AlbertGBarber/Pixel-Mask/PCB Ver Stuff and Code (not for Instructable)/PCB Files/IMG_20201108_145438.jpg

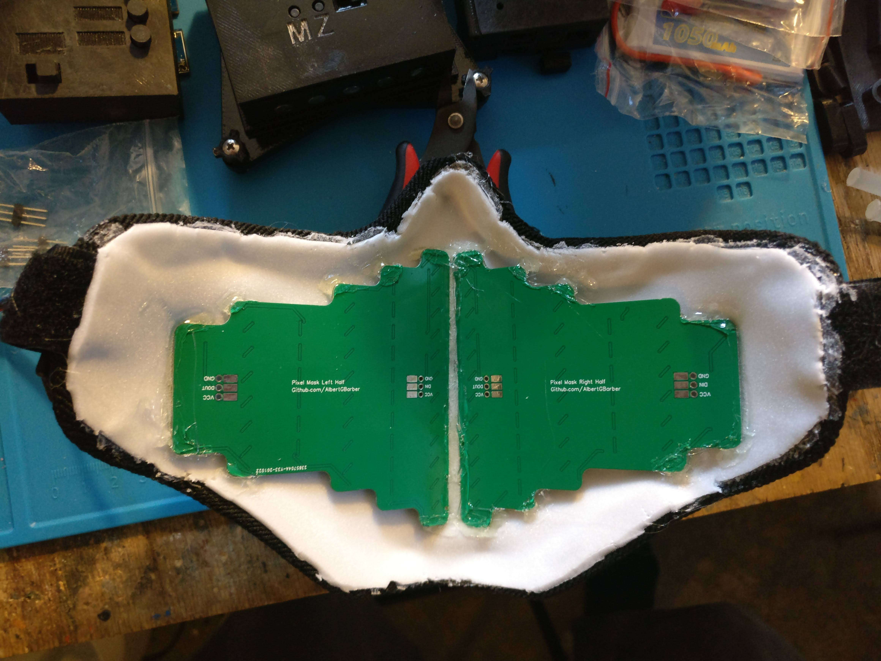
PCB Ver Stuff and Code (not for Instructable)/PCB Files/IMG_20201108_145438.jpg
