AlbertGBarber/Pixel-Mask/PCB Ver Stuff and Code (not for Instructable)/PCB Files/IMG_20201108_150416.jpg

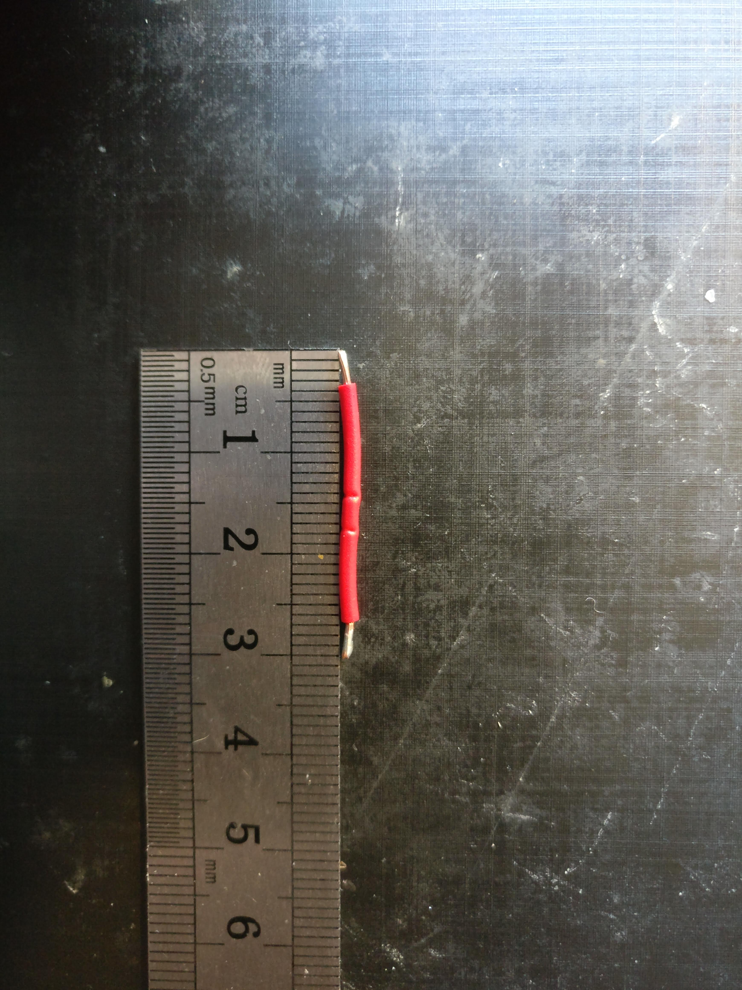
PCB Ver Stuff and Code (not for Instructable)/PCB Files/IMG_20201108_150416.jpg
