AlbertGBarber/Pixel-Mask/README.md

# Pixel-Mask
See https://www.instructables.com/id/Neopixel-LED-Face-Mask
for asembly instructions/details
