AlbertGBarber/Pixel-Mask/Images/IMG_20200503_162246.jpg

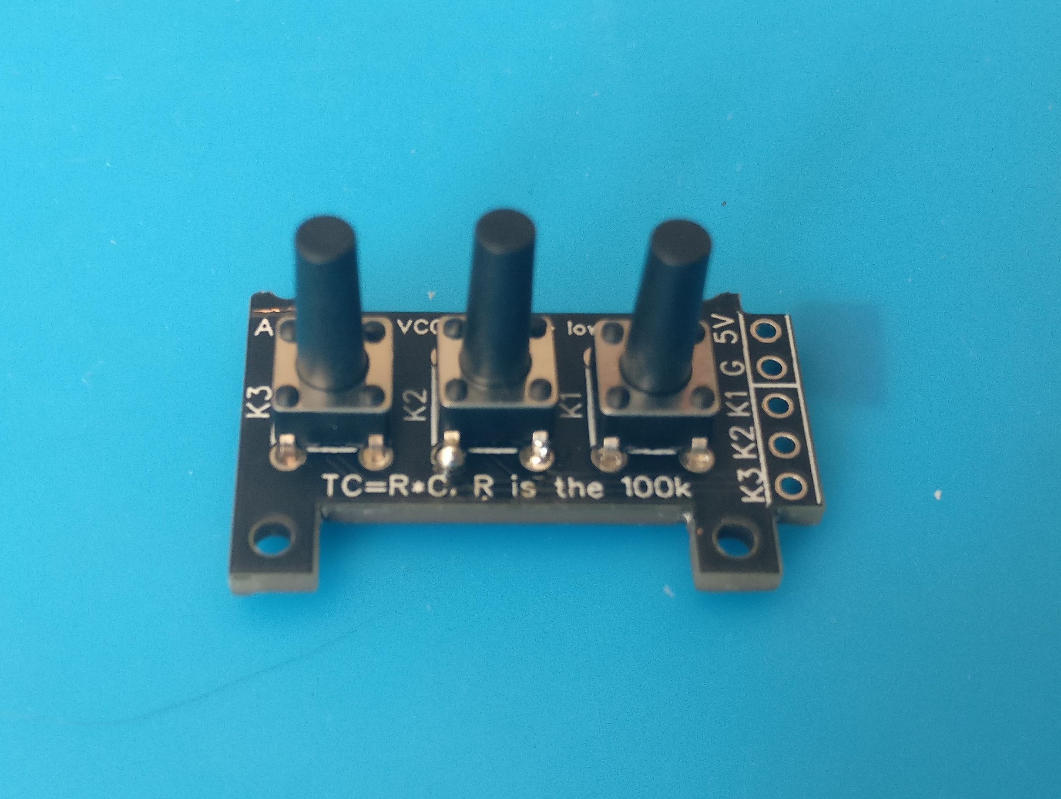
Images/IMG_20200503_162246.jpg
