AlbertGBarber/Pixel-Mask/Images/IMG_20200503_162300.jpg

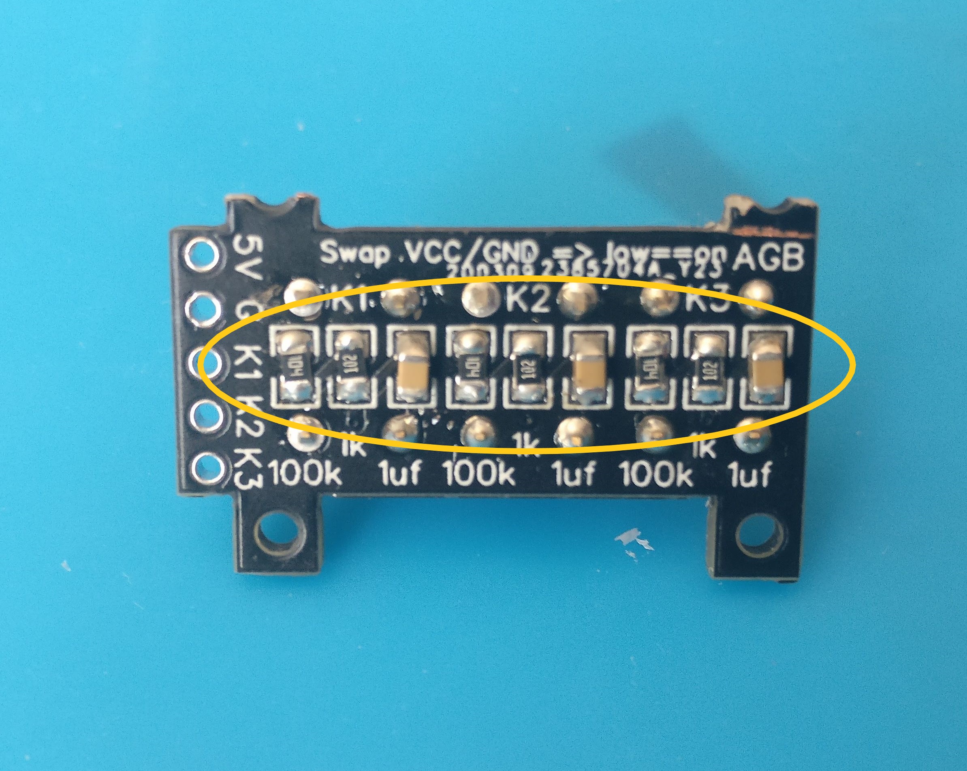
Images/IMG_20200503_162300.jpg
