AlbertGBarber/Pixel-Mask/Images/IMG_20200504_150240.jpg

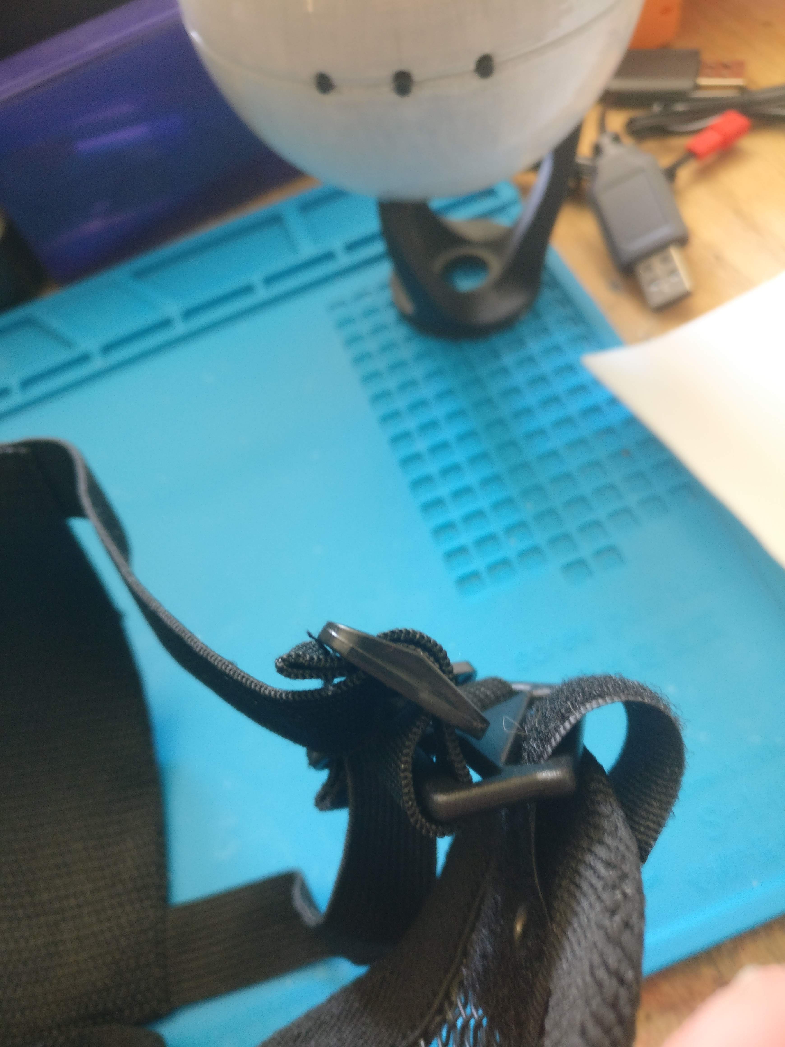
Images/IMG_20200504_150240.jpg
