AlbertGBarber/Pixel-Mask/Images/IMG_20200504_154751.jpg

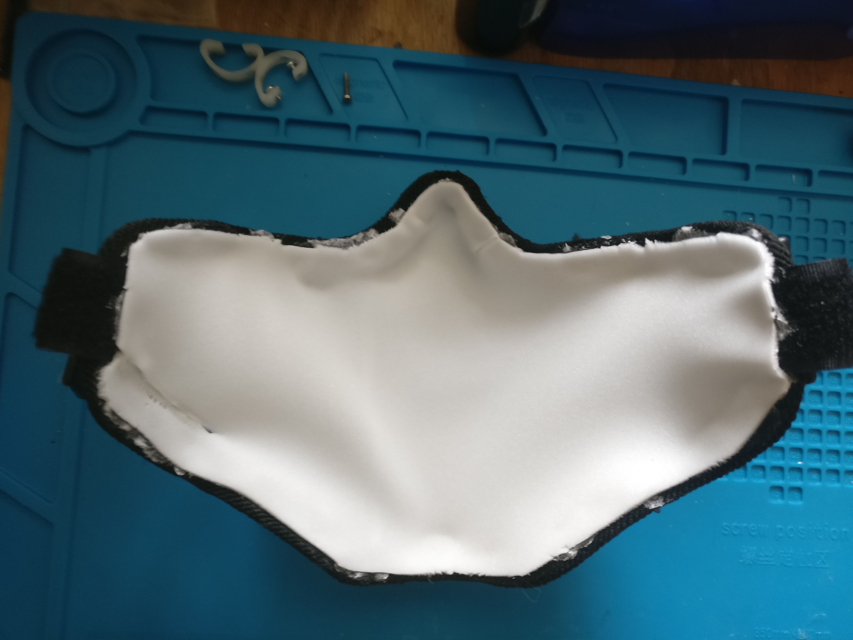
Images/IMG_20200504_154751.jpg
