AlbertGBarber/Pixel-Mask/Images/IMG_20200504_160654.jpg

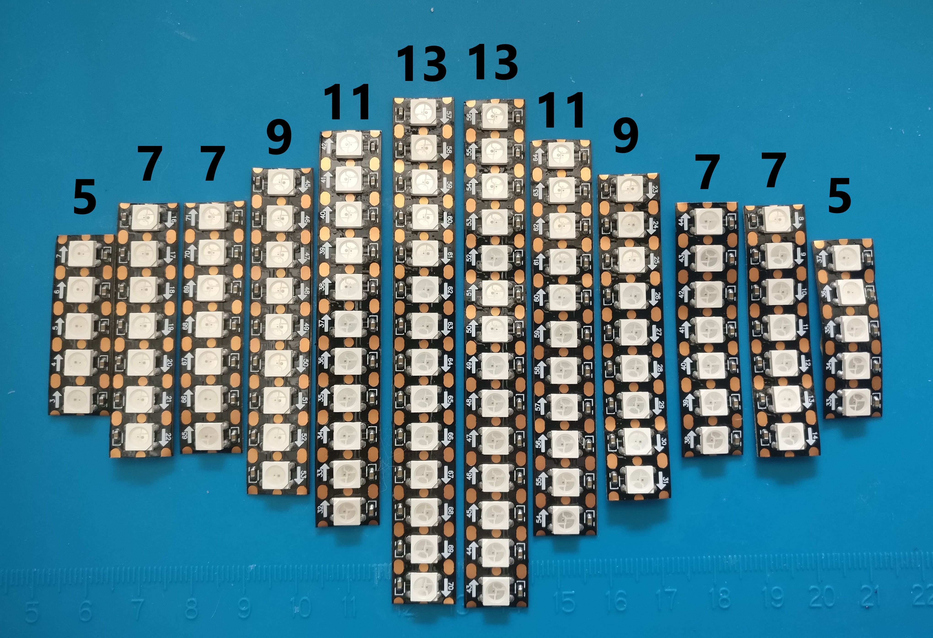
Images/IMG_20200504_160654.jpg
