AlbertGBarber/Pixel-Mask/Images/IMG_20200508_162140.jpg

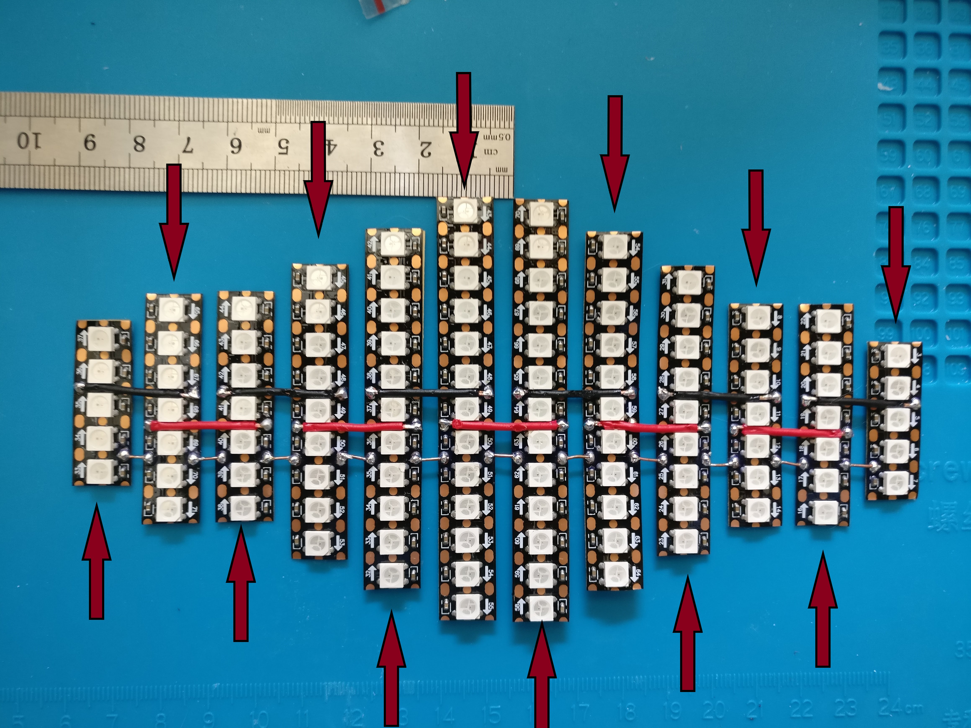
Images/IMG_20200508_162140.jpg
