AlbertGBarber/Pixel-Mask/Images/IMG_20200509_161529.jpg

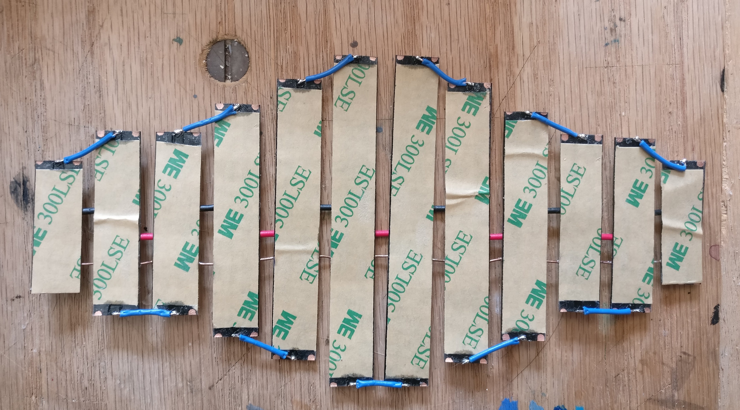
Images/IMG_20200509_161529.jpg
