AlbertGBarber/Pixel-Mask/Images/IMG_20200509_161537.jpg

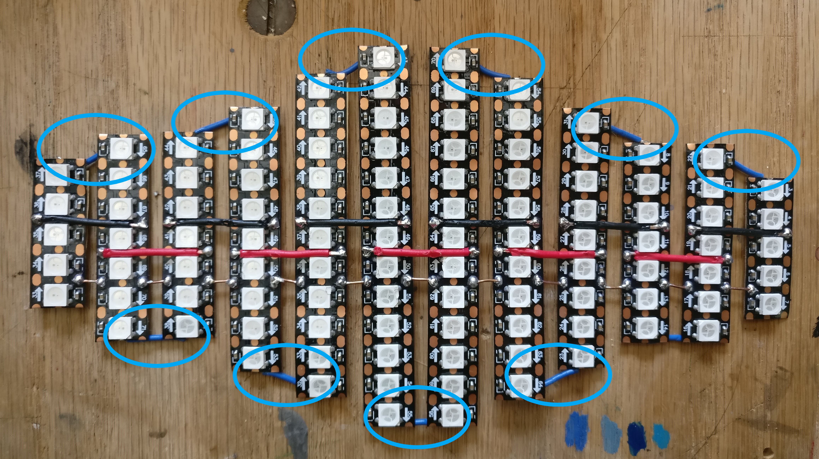
Images/IMG_20200509_161537.jpg
