AlbertGBarber/Pixel-Mask/Images/IMG_20200509_163230.jpg

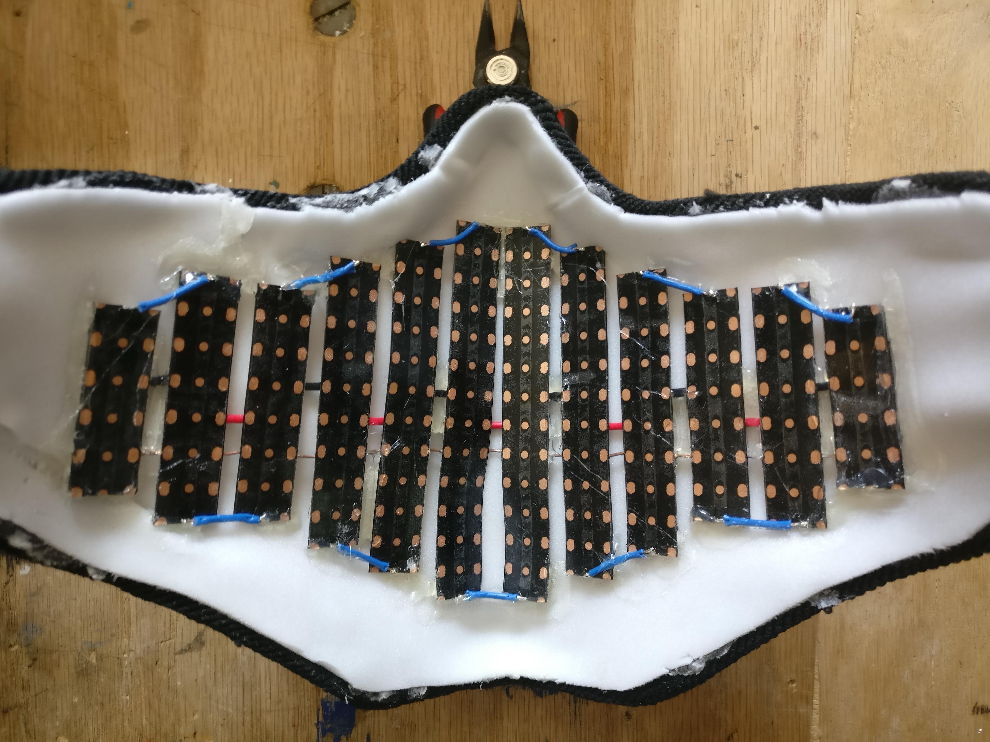
Images/IMG_20200509_163230.jpg
