AlbertGBarber/Pixel-Mask/Images/IMG_20200509_165532.jpg

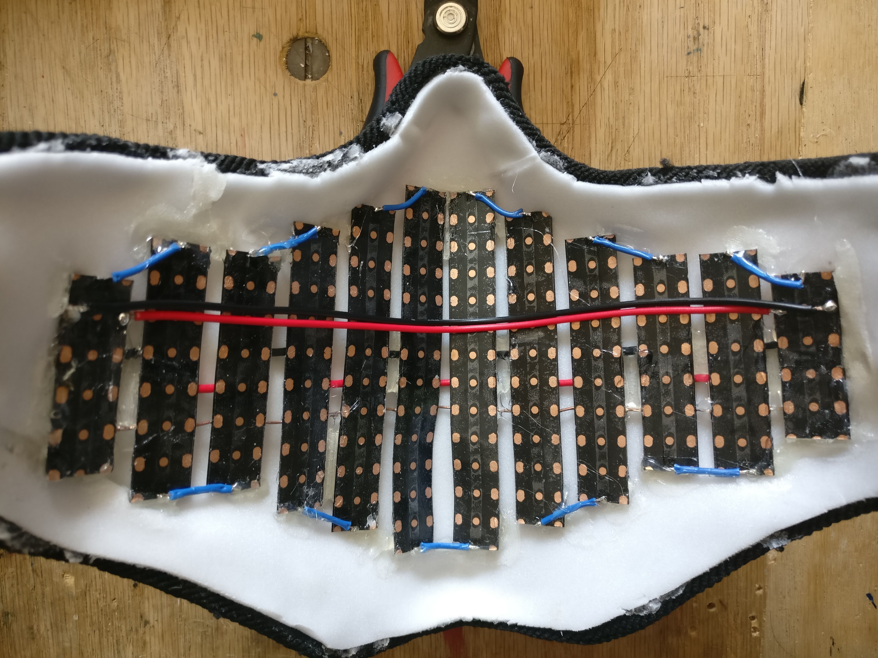
Images/IMG_20200509_165532.jpg
