AlbertGBarber/Pixel-Mask/Images/IMG_20200510_094328.jpg

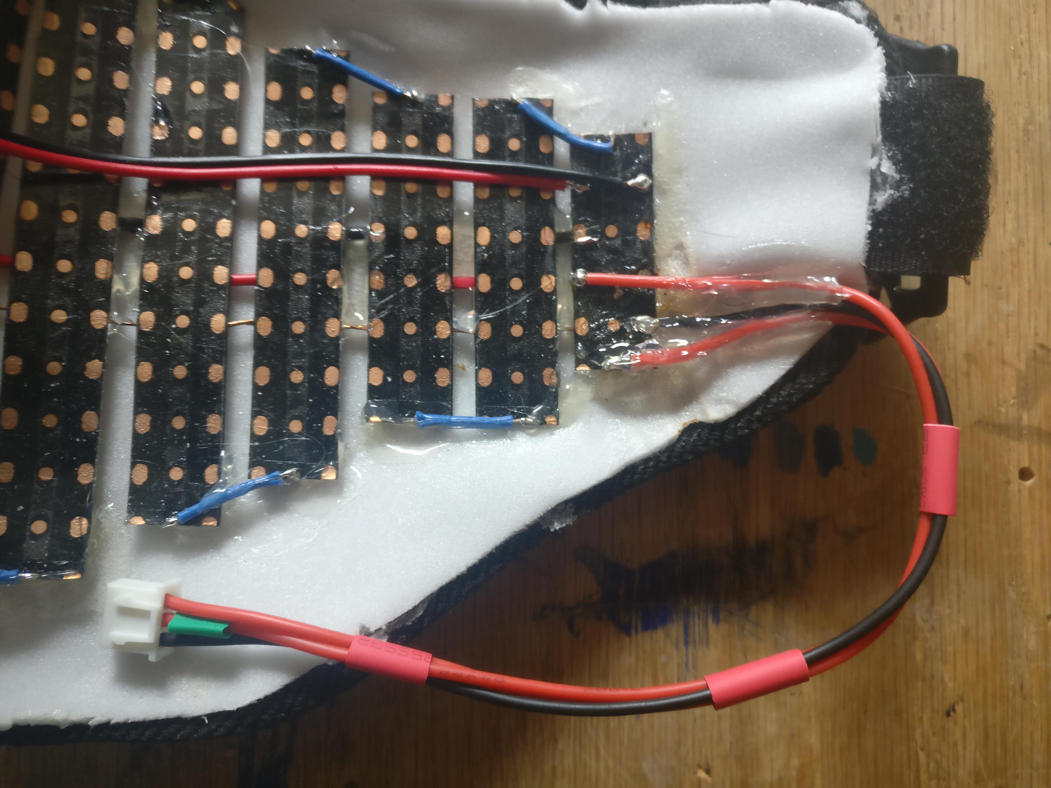
Images/IMG_20200510_094328.jpg
