AlbertGBarber/Pixel-Mask/Images/IMG_20200510_094334.jpg

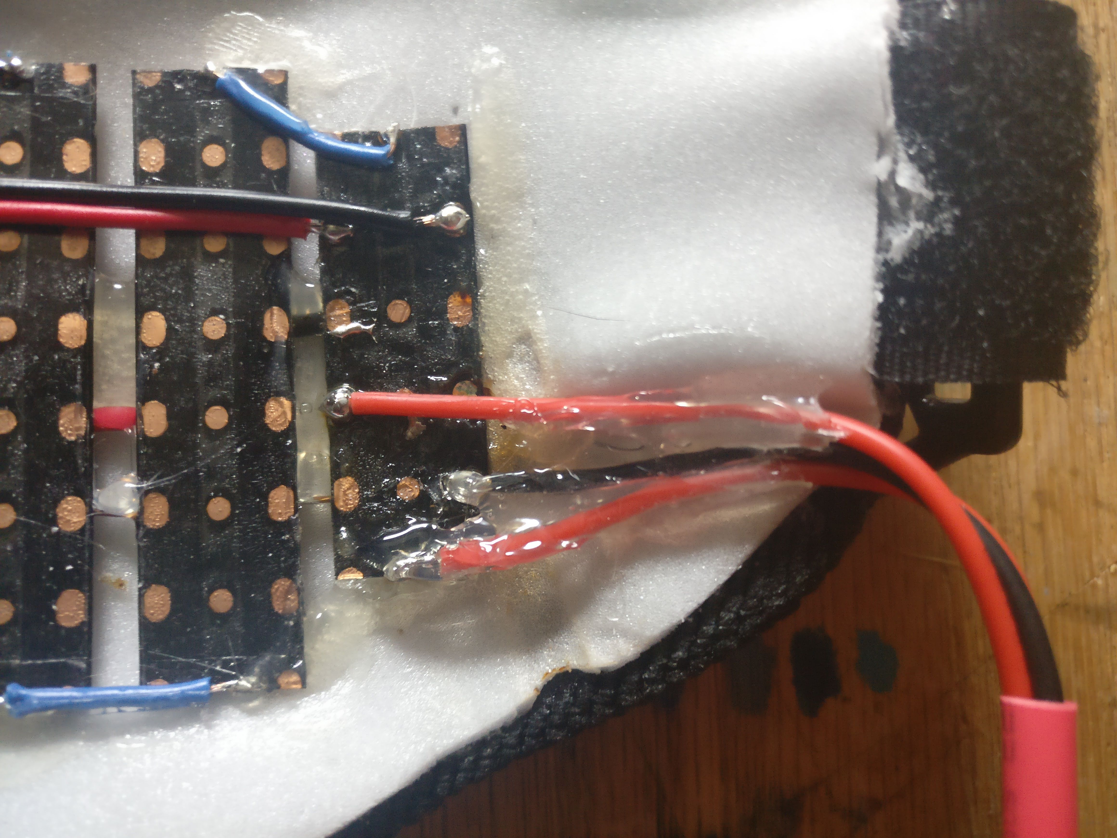
Images/IMG_20200510_094334.jpg
