AlbertGBarber/Pixel-Mask/Images/IMG_20200510_153036.jpg

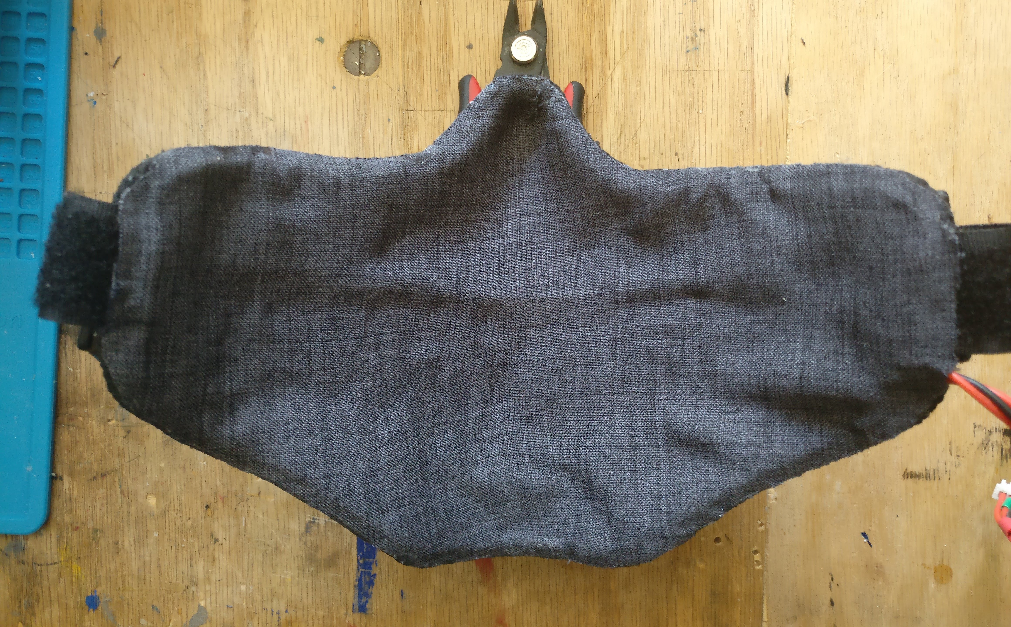
Images/IMG_20200510_153036.jpg
