AlbertGBarber/Pixel-Mask/Images/IMG_20200513_102250.jpg

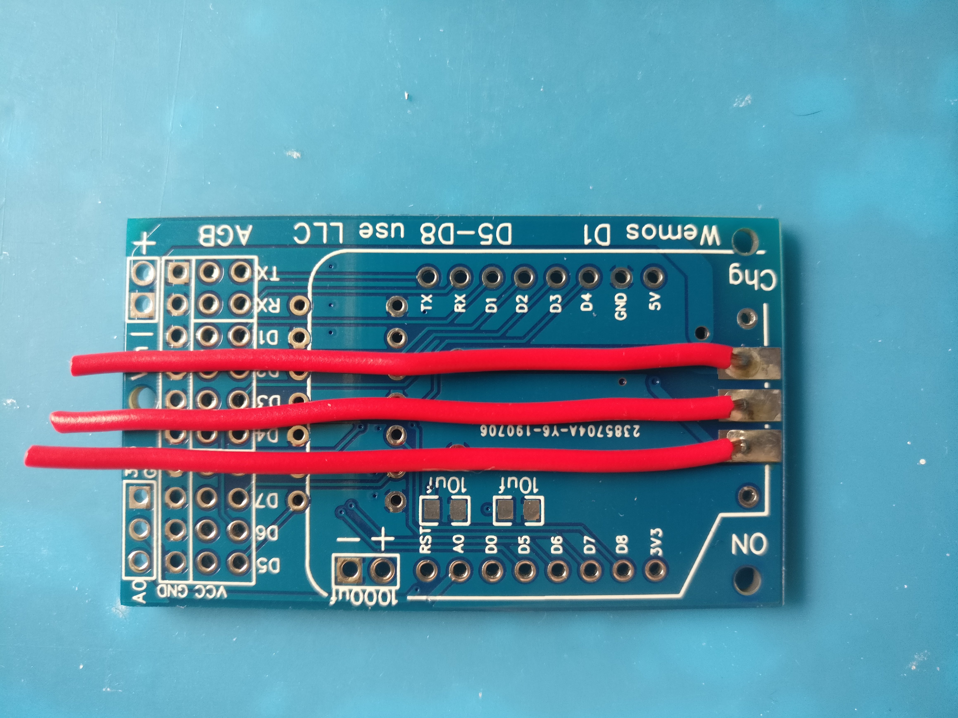
Images/IMG_20200513_102250.jpg
