AlbertGBarber/Pixel-Mask/Images/IMG_20200513_102259.jpg

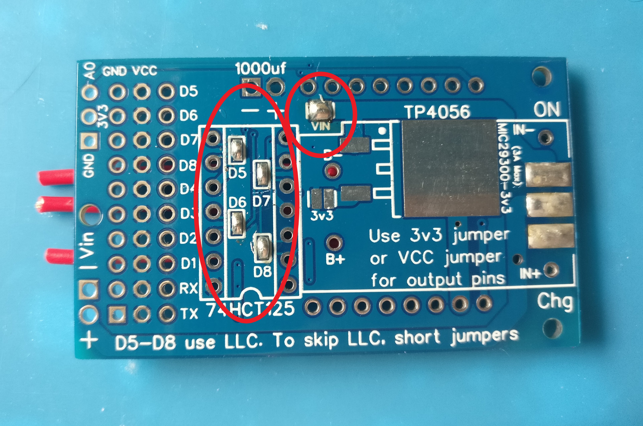
Images/IMG_20200513_102259.jpg
