AlbertGBarber/Pixel-Mask/Images/IMG_20200513_102651.jpg

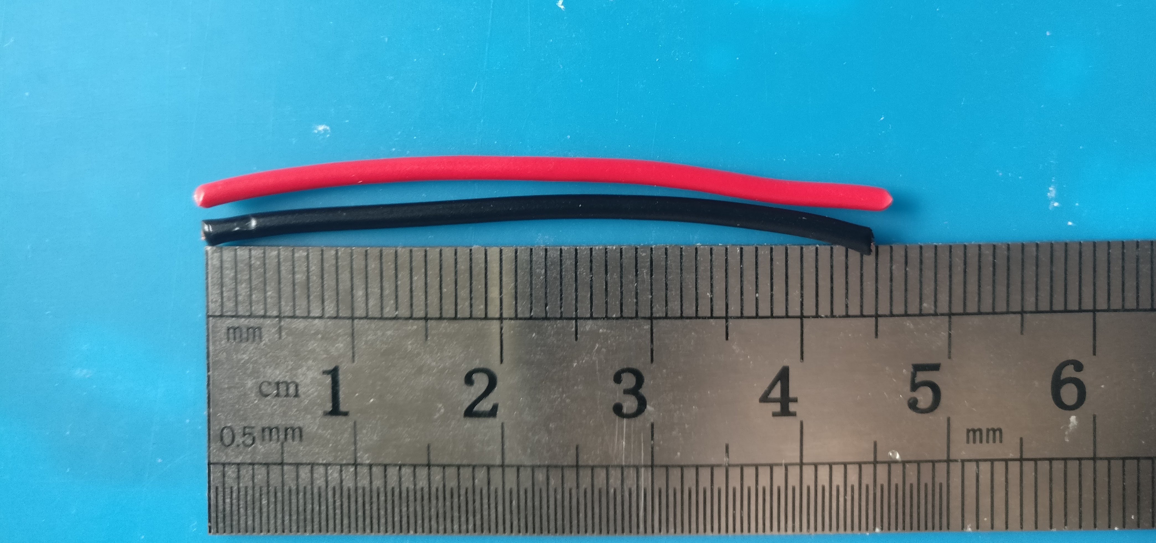
Images/IMG_20200513_102651.jpg
