AlbertGBarber/Pixel-Mask/Images/IMG_20200513_104745.jpg

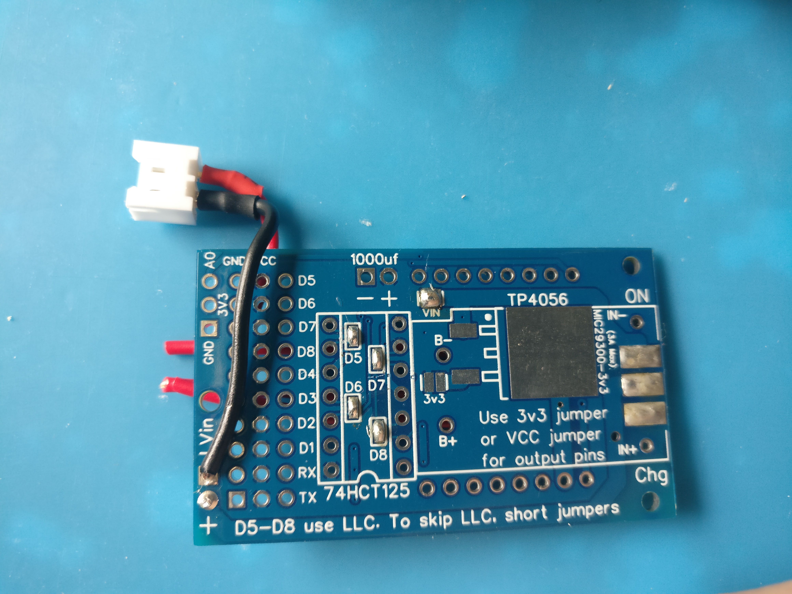
Images/IMG_20200513_104745.jpg
