AlbertGBarber/Pixel-Mask/Images/IMG_20200513_160158.jpg

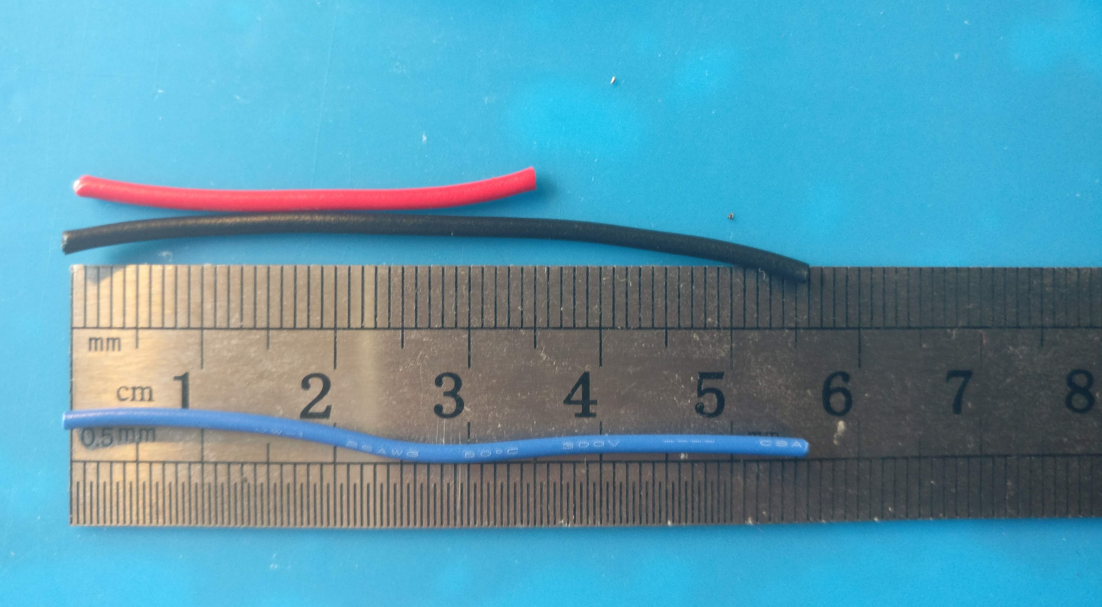
Images/IMG_20200513_160158.jpg
