AlbertGBarber/Pixel-Mask/Images/IMG_20200513_162722.jpg

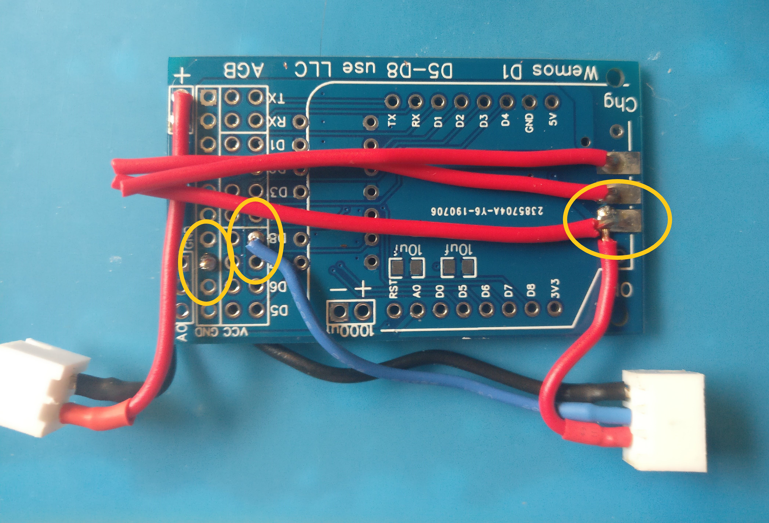
Images/IMG_20200513_162722.jpg
