AlbertGBarber/Pixel-Mask/Images/IMG_20200513_162731.jpg

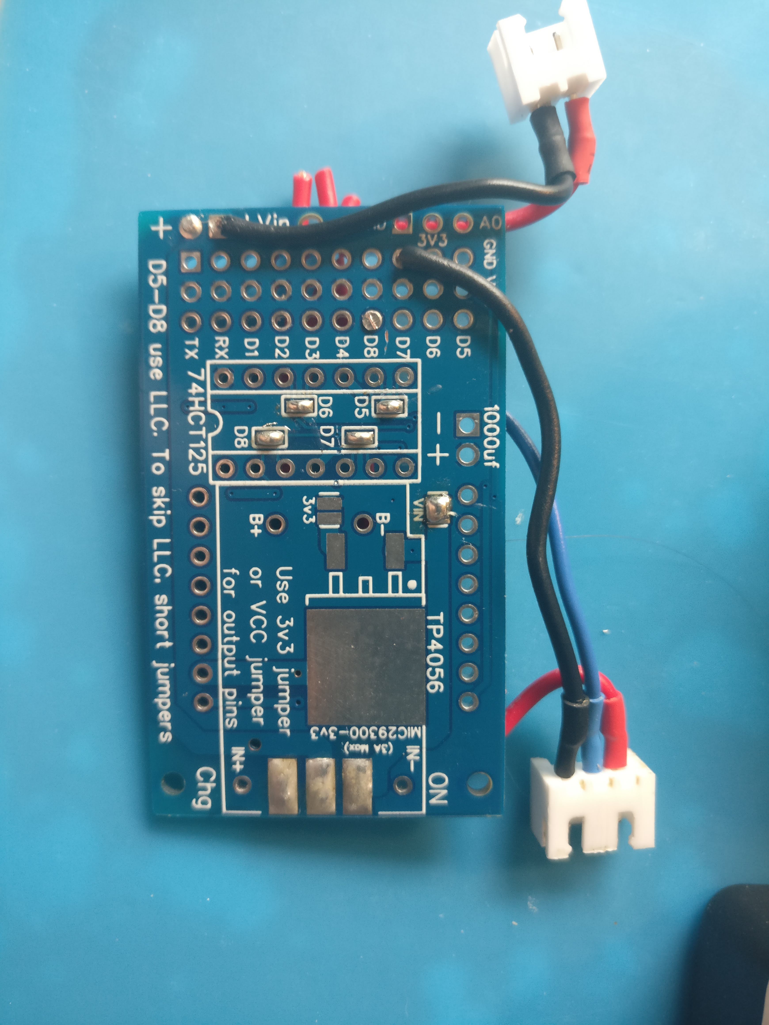
Images/IMG_20200513_162731.jpg
