AlbertGBarber/Pixel-Mask/Images/IMG_20200513_163444.jpg

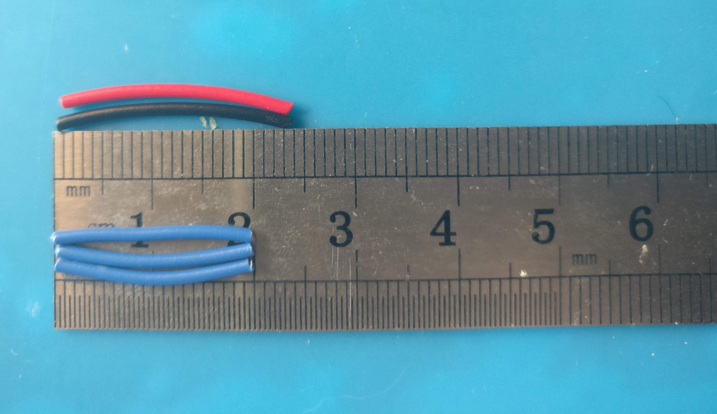
Images/IMG_20200513_163444.jpg
