AlbertGBarber/Pixel-Mask/Images/IMG_20200513_164934.jpg

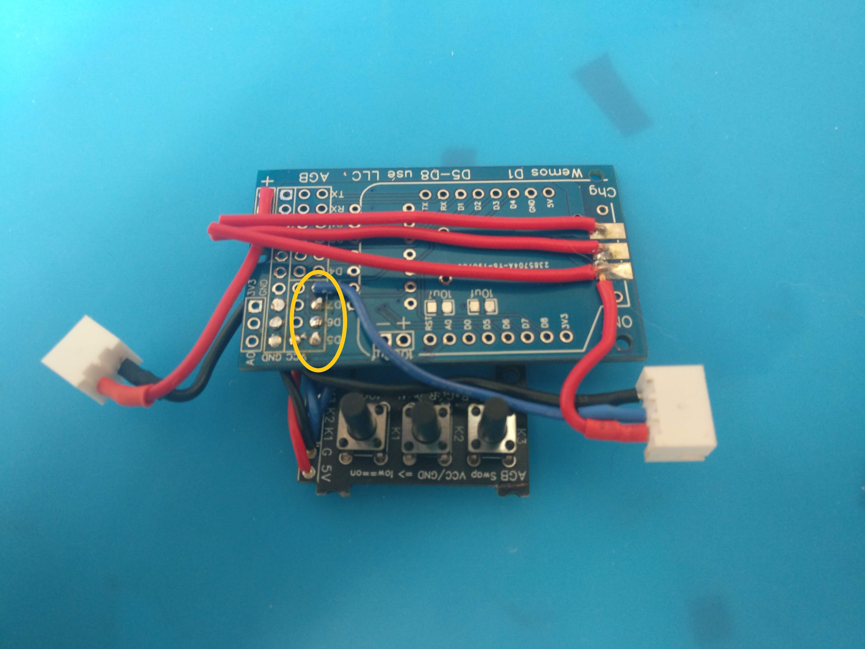
Images/IMG_20200513_164934.jpg
