AlbertGBarber/Pixel-Mask/Images/IMG_20200513_164945.jpg

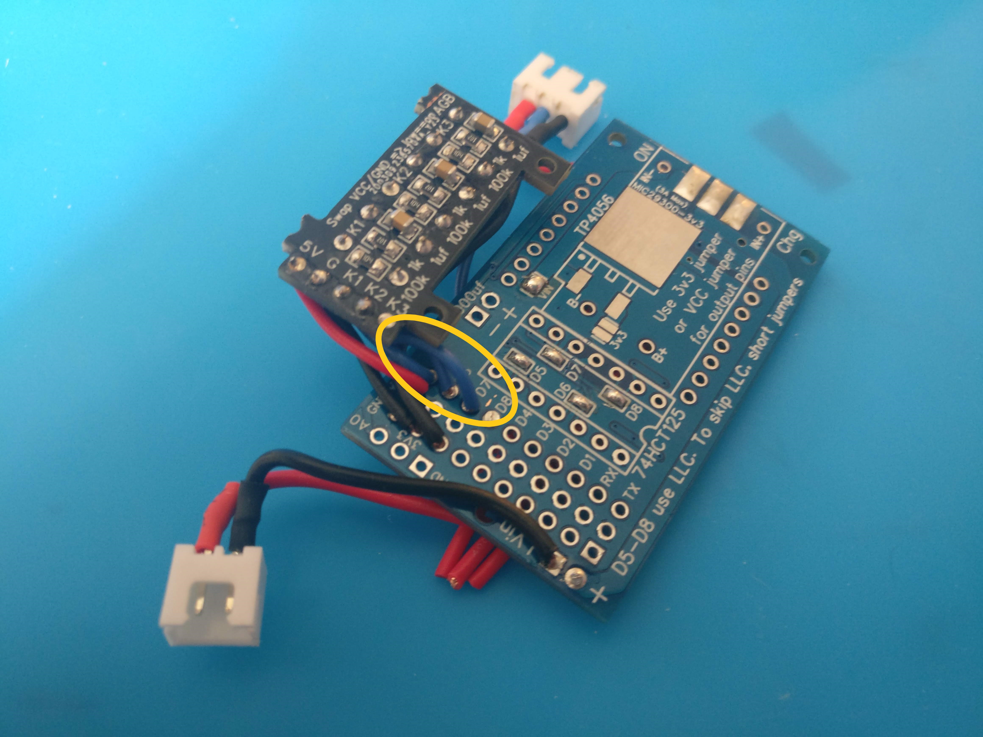
Images/IMG_20200513_164945.jpg
