AlbertGBarber/Pixel-Mask/Images/IMG_20200514_161034.jpg

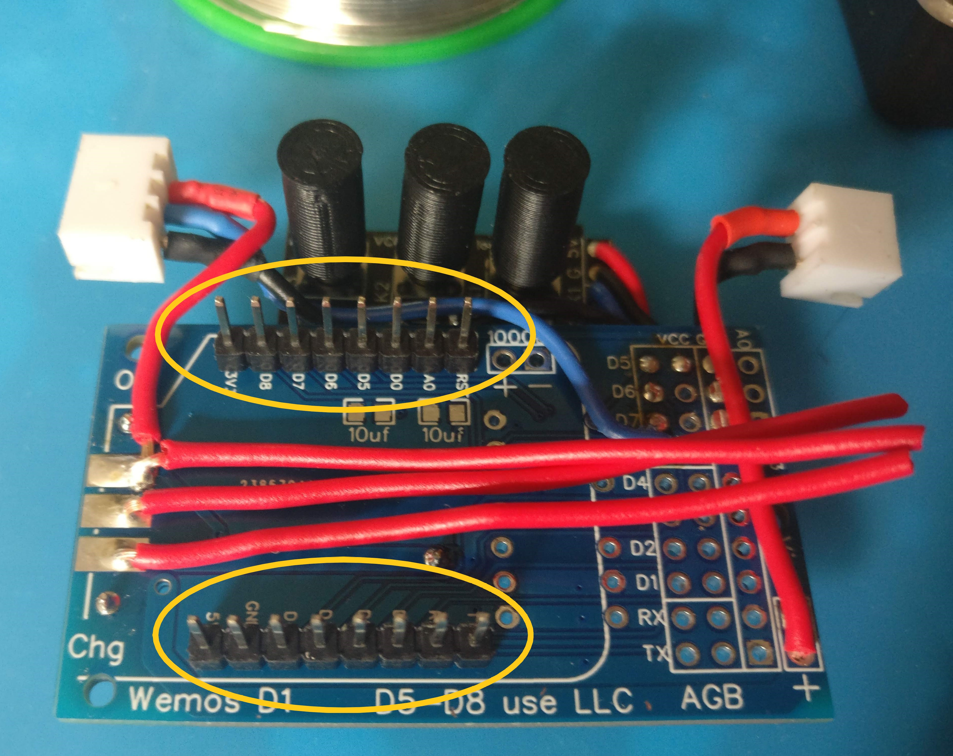
Images/IMG_20200514_161034.jpg
