AlbertGBarber/Pixel-Mask/Images/IMG_20200514_161041.jpg

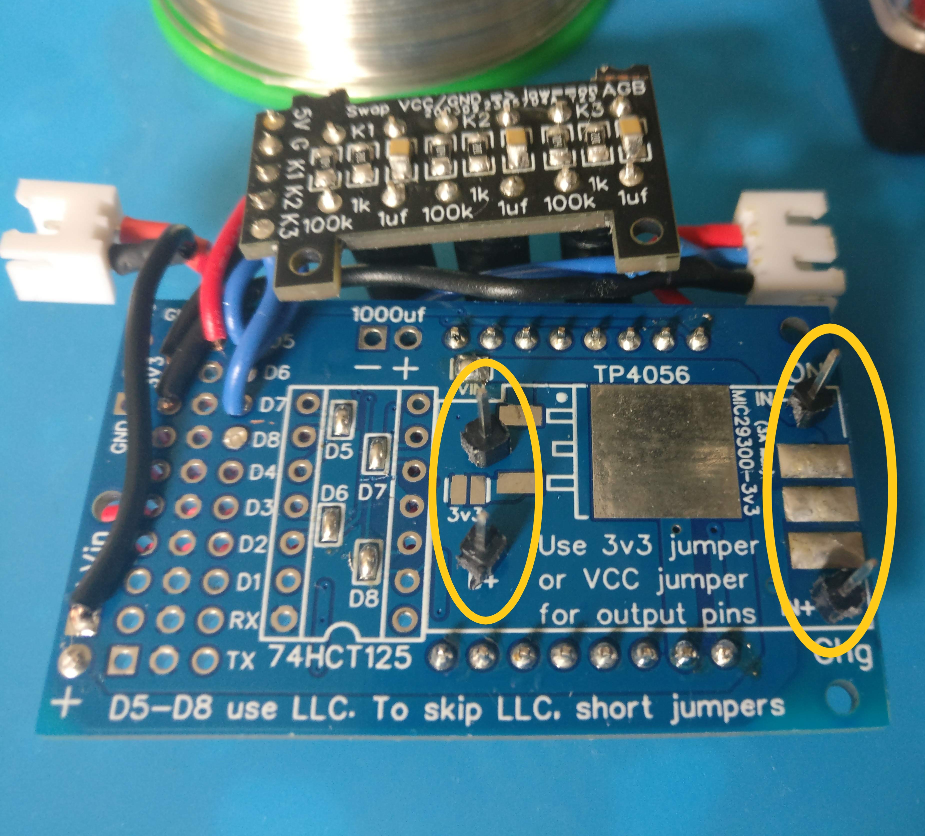
Images/IMG_20200514_161041.jpg
