AlbertGBarber/Pixel-Mask/Images/IMG_20200517_150328.jpg

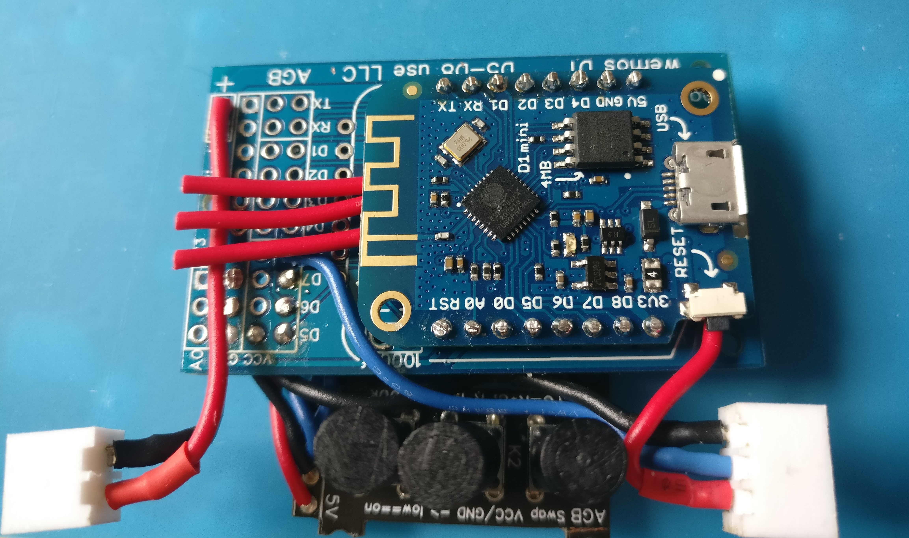
Images/IMG_20200517_150328.jpg
