AlbertGBarber/Pixel-Mask/Images/IMG_20200517_150339.jpg

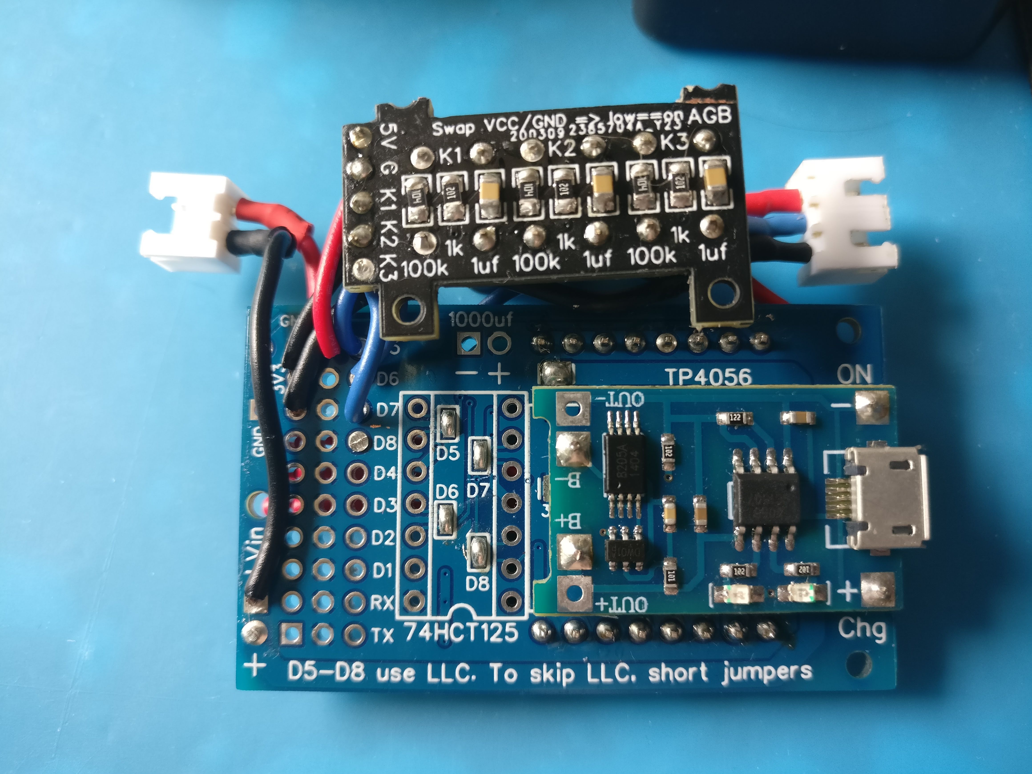
Images/IMG_20200517_150339.jpg
