AlbertGBarber/Pixel-Mask/Images/IMG_20200517_152512.jpg

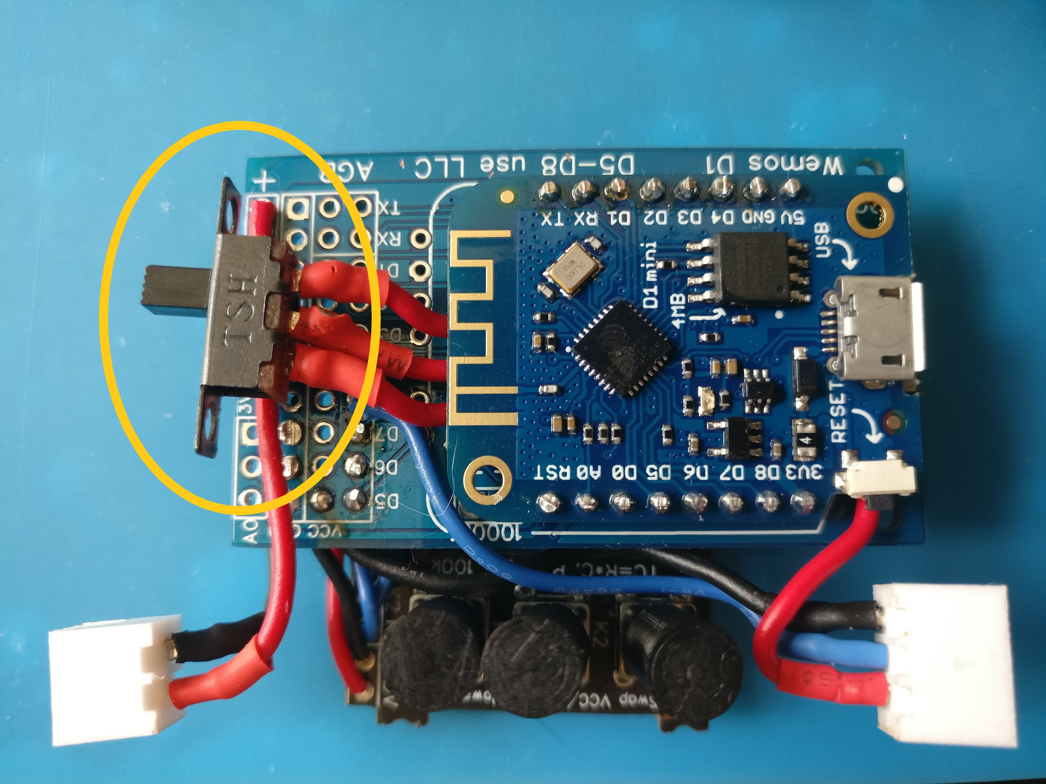
Images/IMG_20200517_152512.jpg
