AlbertGBarber/Pixel-Mask/Images/IMG_20200517_161505.jpg

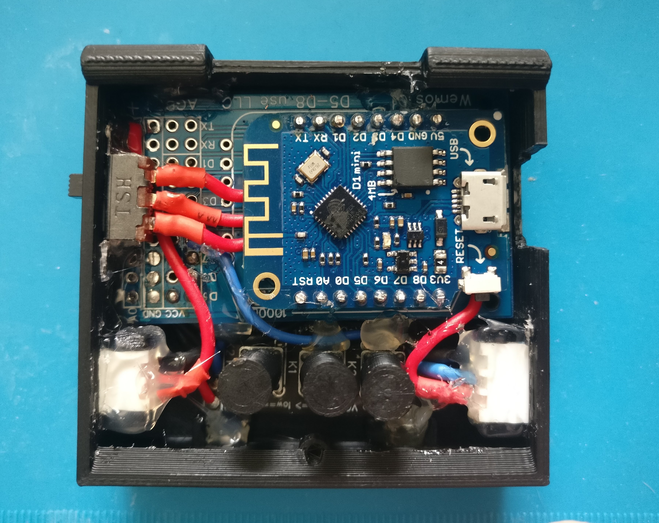
Images/IMG_20200517_161505.jpg
