AlbertGBarber/Pixel-Mask/Images/IMG_20200517_165818.jpg

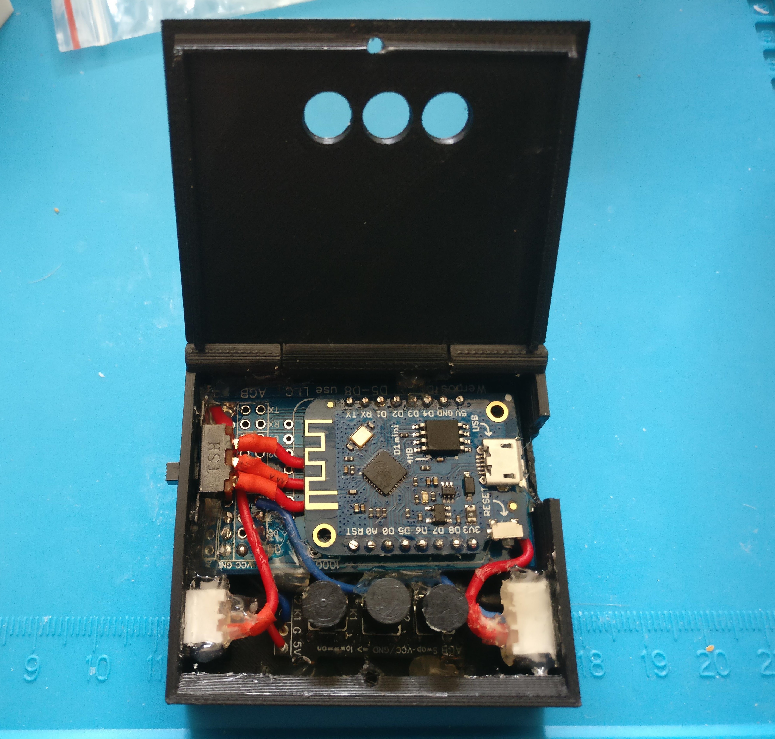
Images/IMG_20200517_165818.jpg
