AlbertGBarber/Pixel-Mask/Images/IMG_20200517_170713.jpg

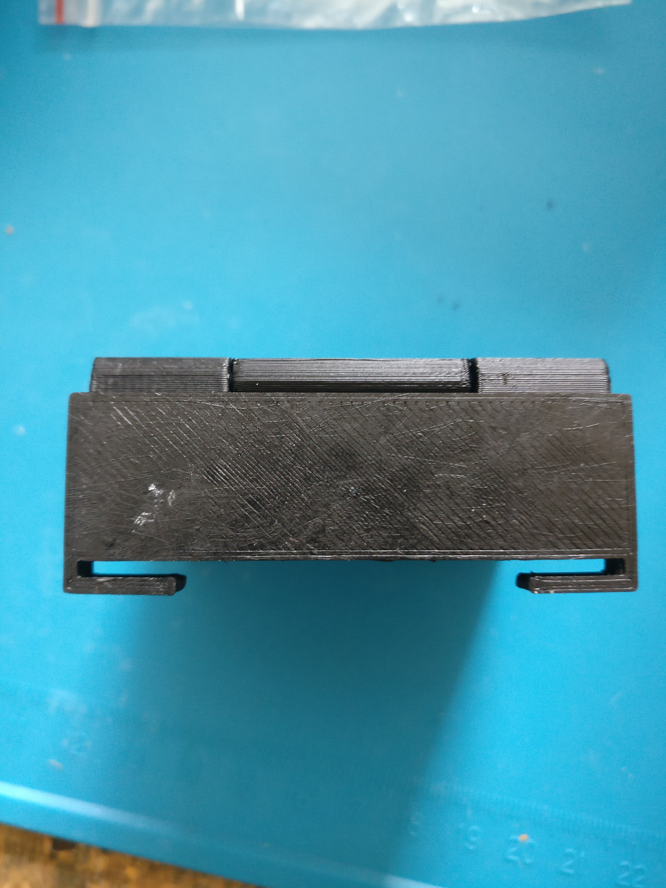
Images/IMG_20200517_170713.jpg
