AlbertGBarber/Pixel-Mask/Images/IMG_20200517_170718.jpg

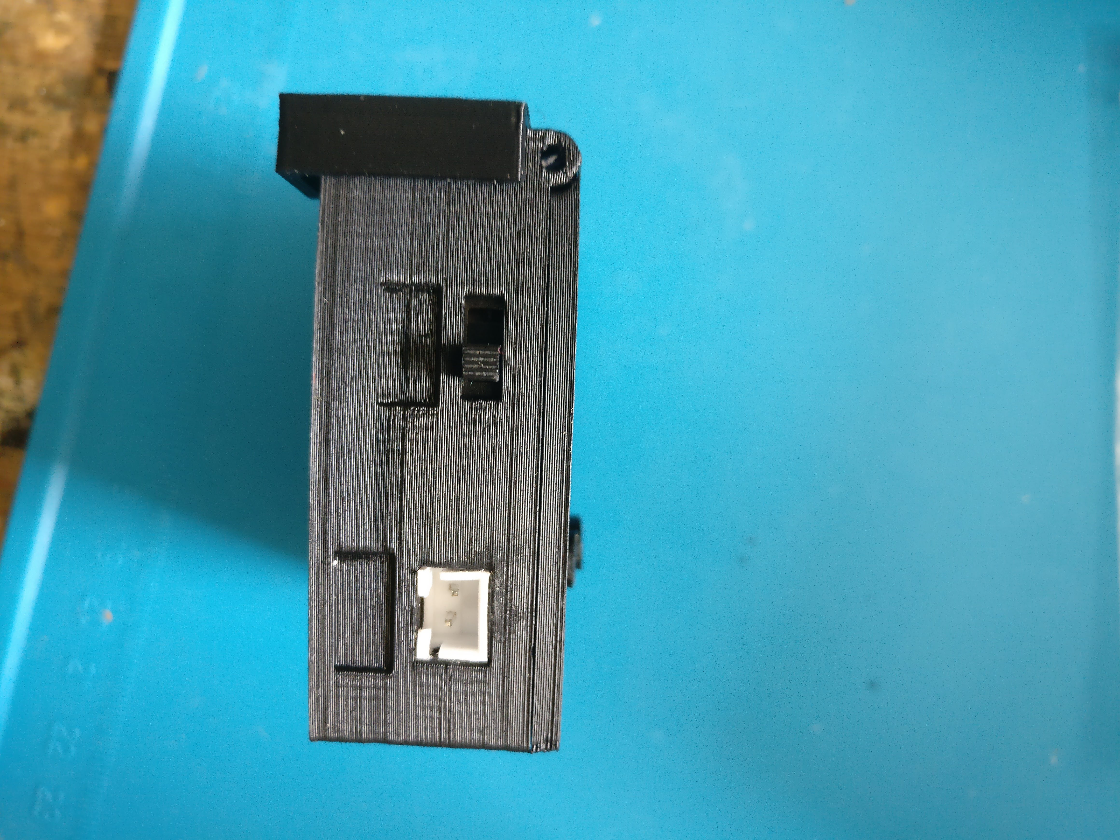
Images/IMG_20200517_170718.jpg
