AlbertGBarber/Pixel-Mask/Images/IMG_20200518_102150.jpg

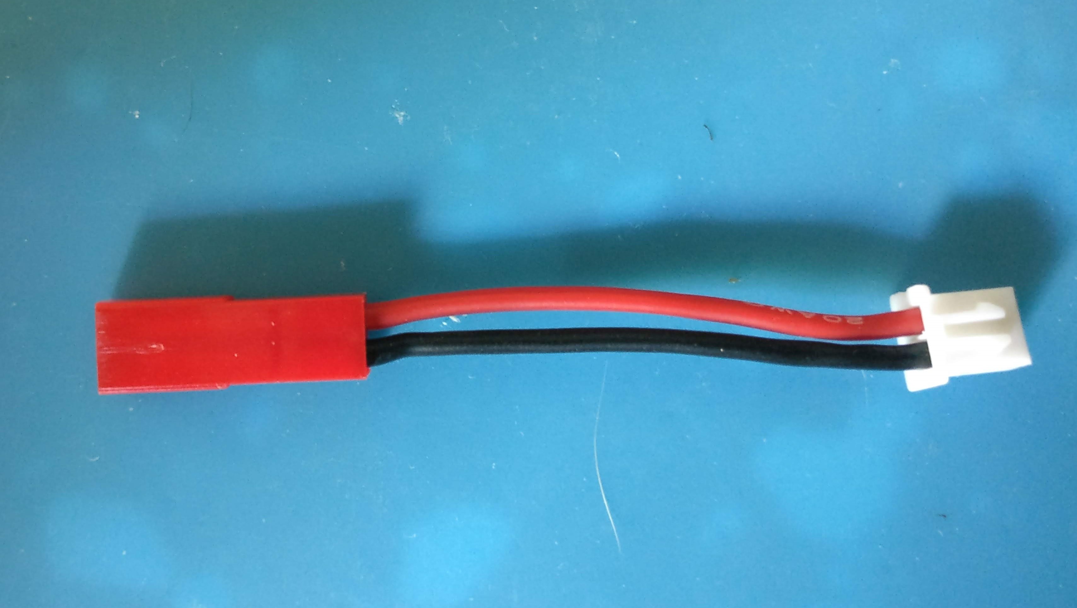
Images/IMG_20200518_102150.jpg
