AlbertGBarber/Pixel-Mask/Images/IMG_20200712_151451.jpg

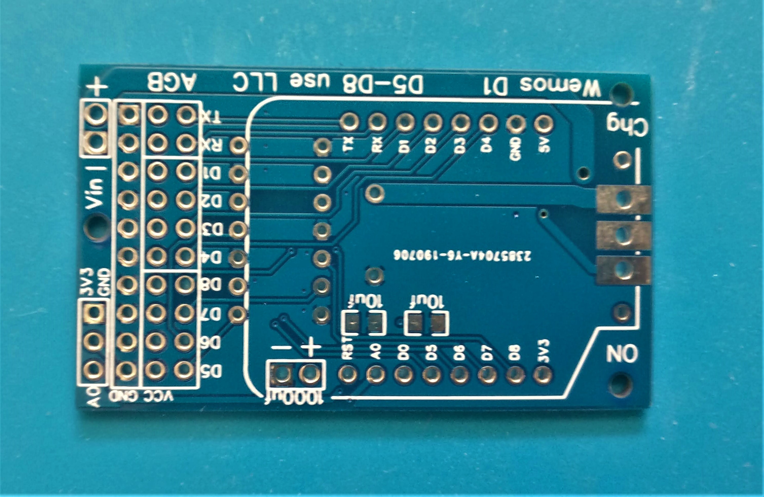
Images/IMG_20200712_151451.jpg
