AlbertGBarber/Pixel-Mask/Images/IMG_20200712_161810.jpg

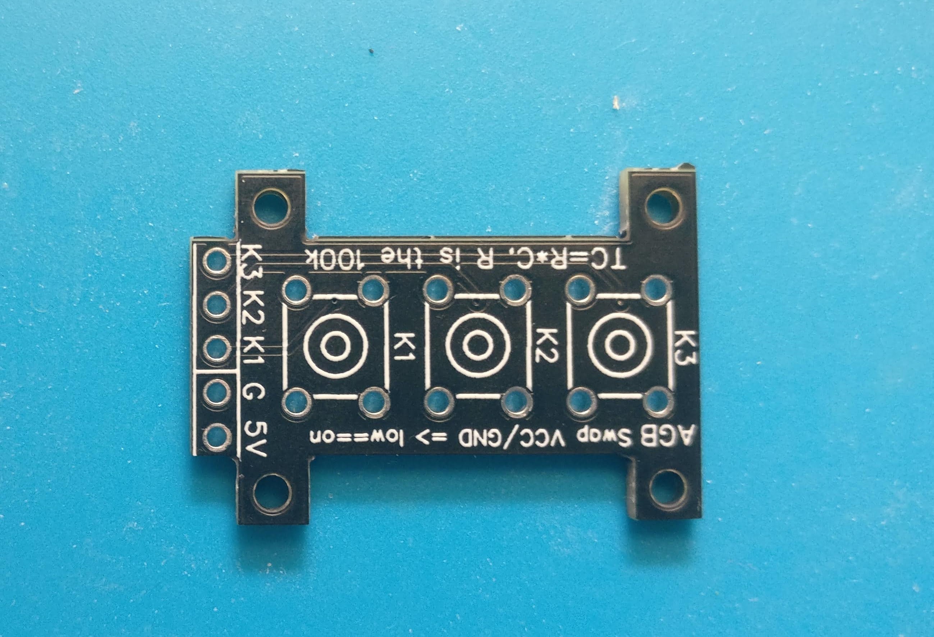
Images/IMG_20200712_161810.jpg
