AlbertGBarber/Pixel-Mask/Images/IMG_20200713_163224.jpg

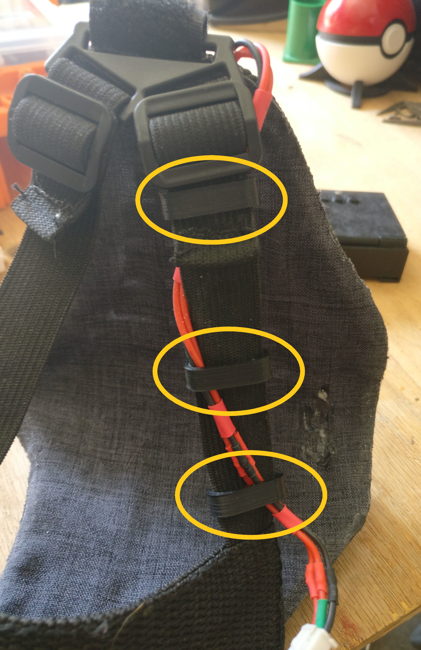
Images/IMG_20200713_163224.jpg
