AlbertGBarber/Pixel-Mask/Images/IMG_20200713_163251.jpg

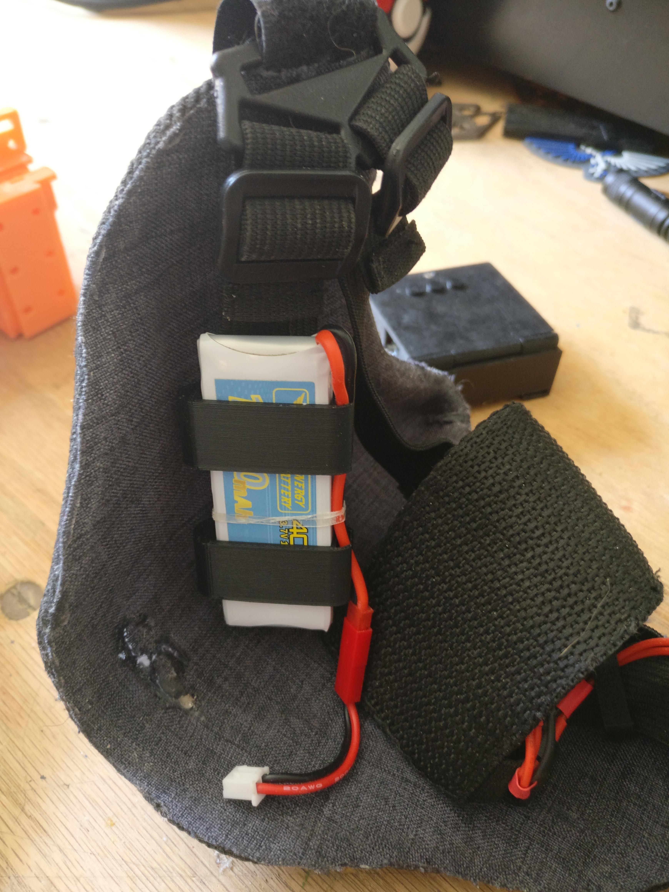
Images/IMG_20200713_163251.jpg
