AlbertGBarber/Pixel-Mask/Images/IMG_20200713_163353.jpg

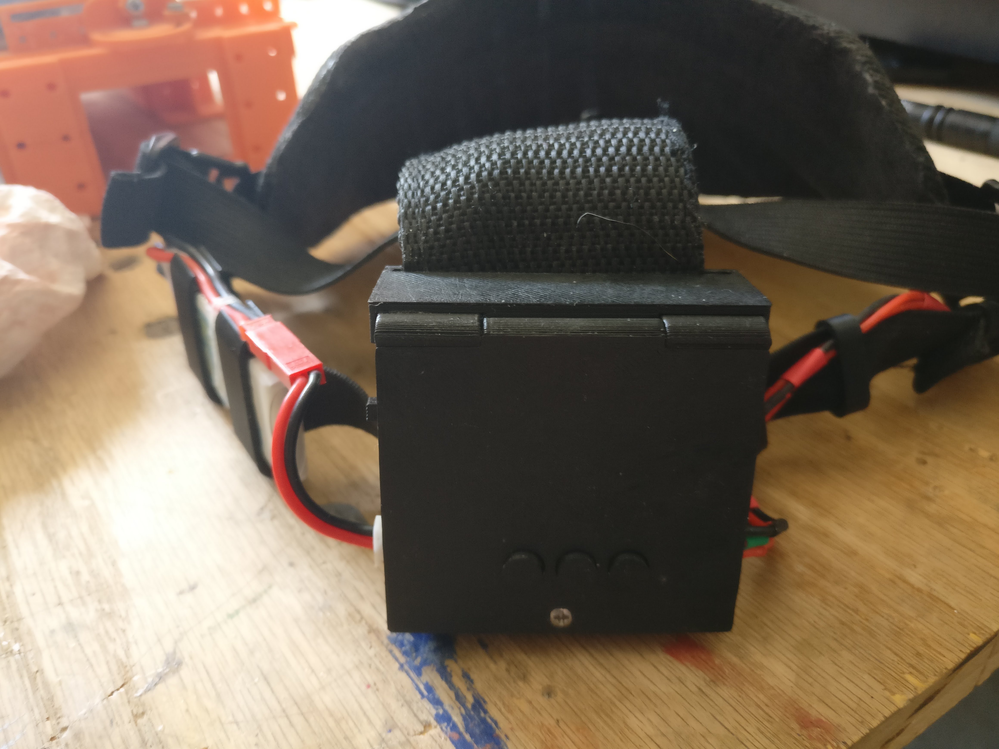
Images/IMG_20200713_163353.jpg
