AlbertGBarber/Pixel-Mask/Images/IMG_20200713_163359.jpg

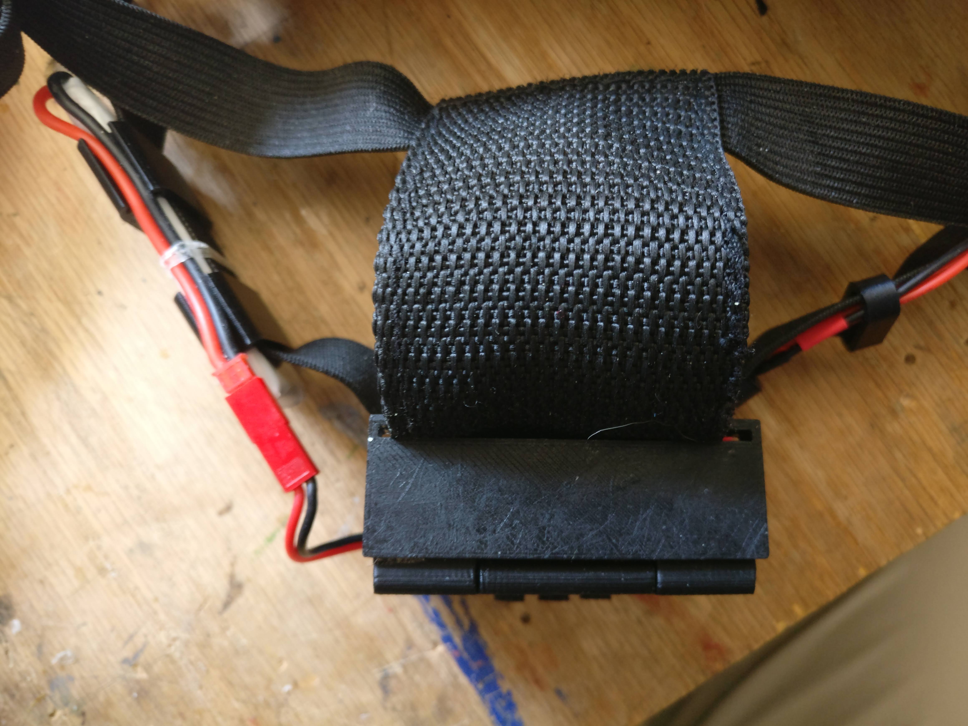
Images/IMG_20200713_163359.jpg
