AlbertGBarber/Pixel-Mask/Images/IMG_20200713_163405.jpg

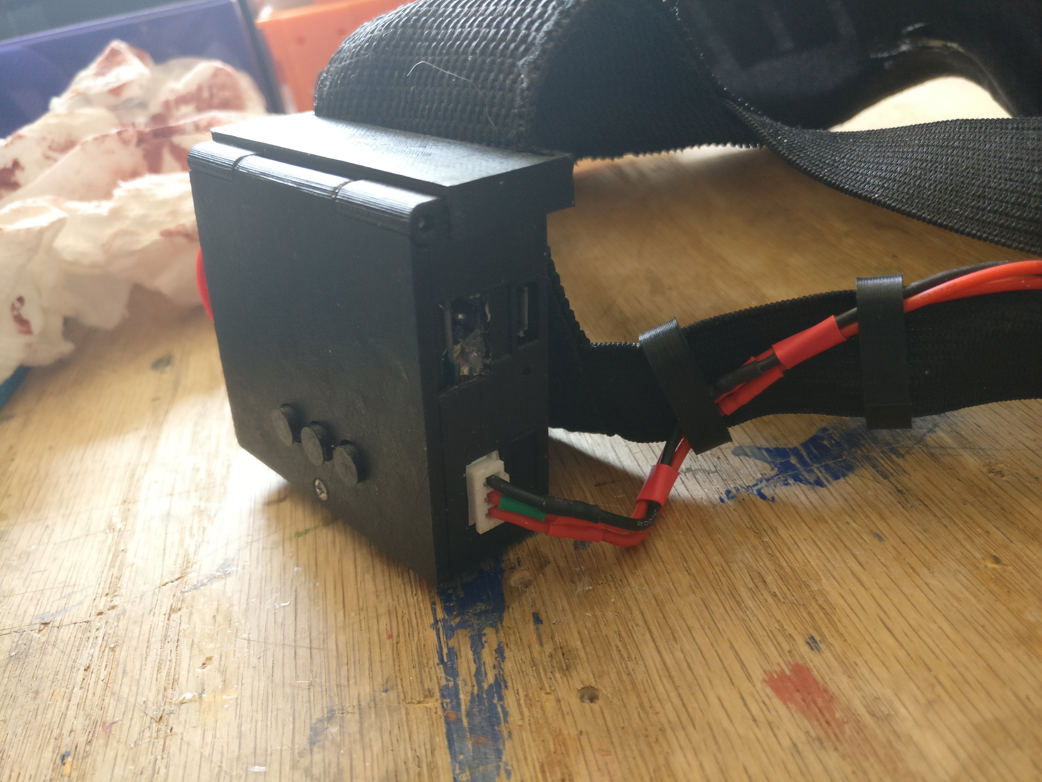
Images/IMG_20200713_163405.jpg
