AlbertGBarber/Pixel-Mask/Images/IMG_20200713_163411.jpg

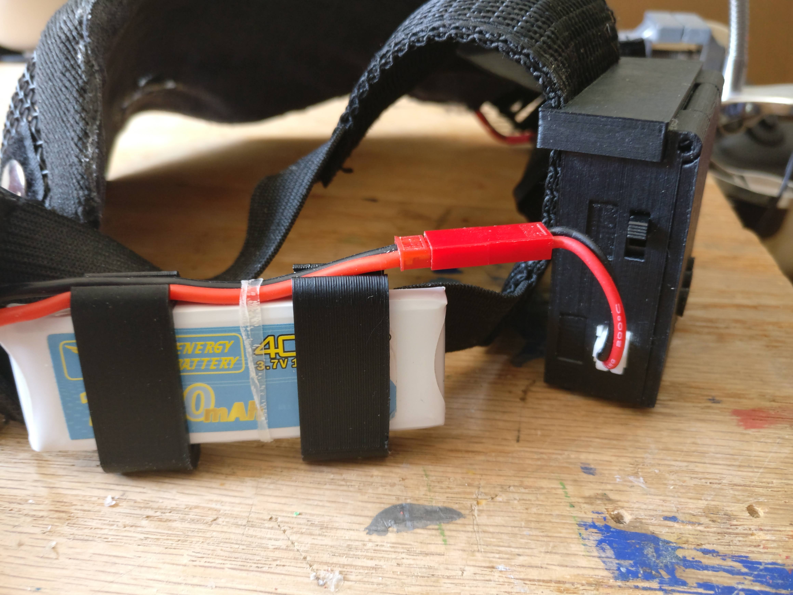
Images/IMG_20200713_163411.jpg
