AlbertGBarber/Pixel-Mask/Images/IMG_20200723_154335.jpg

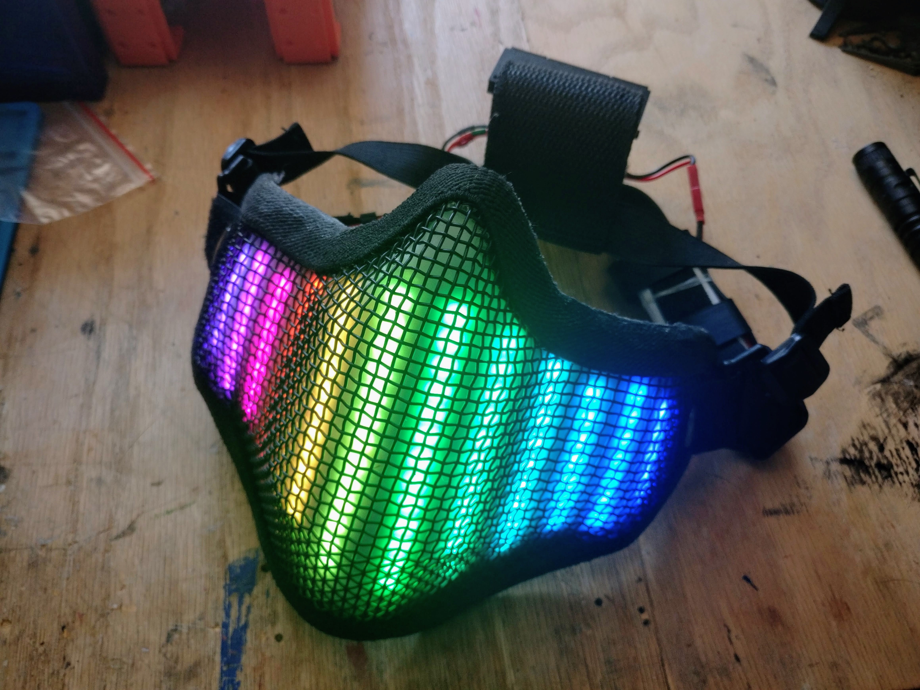
Images/IMG_20200723_154335.jpg
