AlbertGBarber/Pixel-Mask/Images/IMG_20200723_154343.jpg

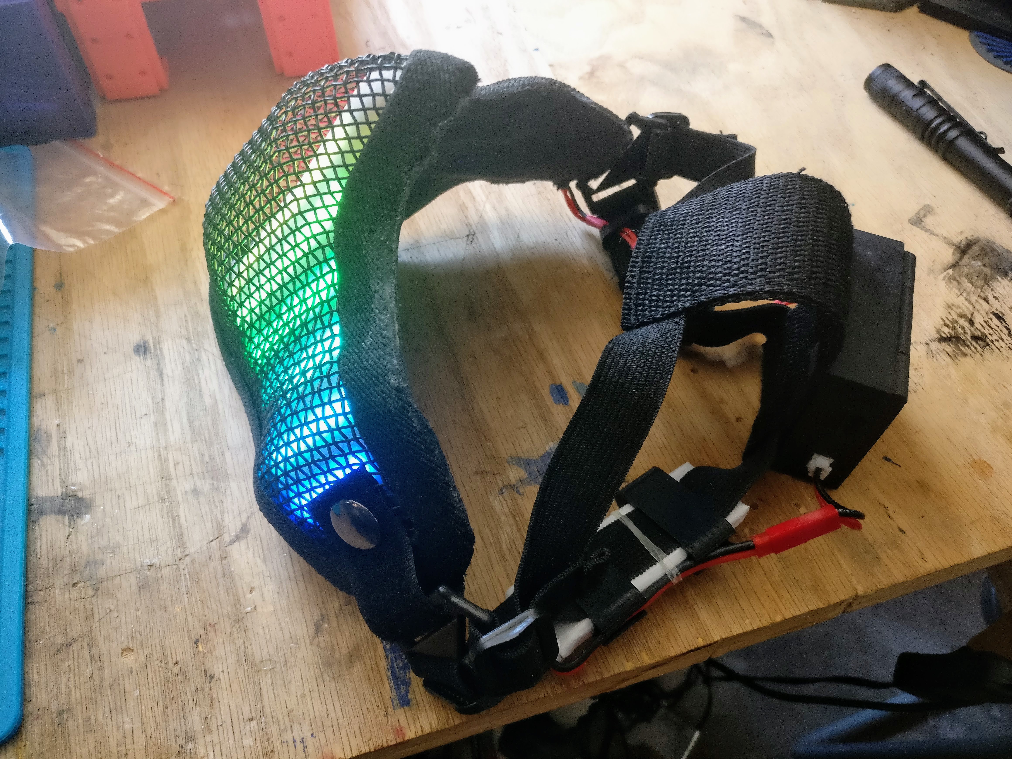
Images/IMG_20200723_154343.jpg
