AlbertGBarber/Pixel-Mask/Images/IMG_20200723_154904.jpg

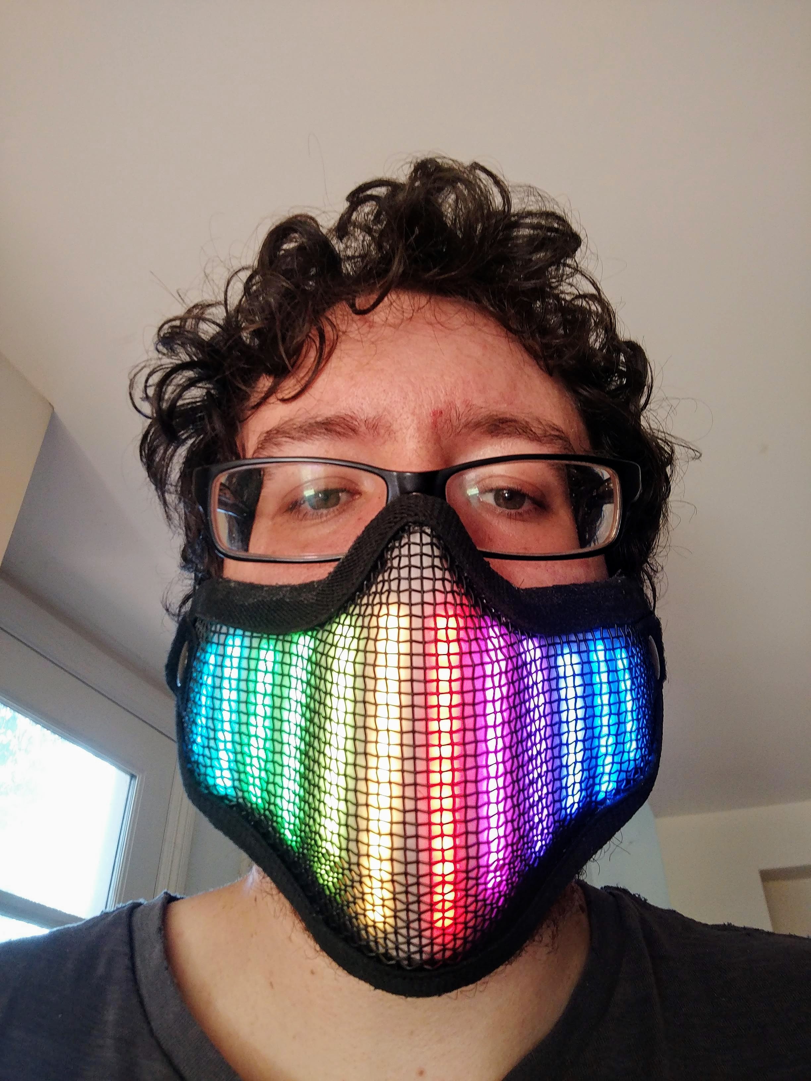
Images/IMG_20200723_154904.jpg
