AlbertGBarber/Pixel-Mask/Images/IMG_20200723_155159.jpg

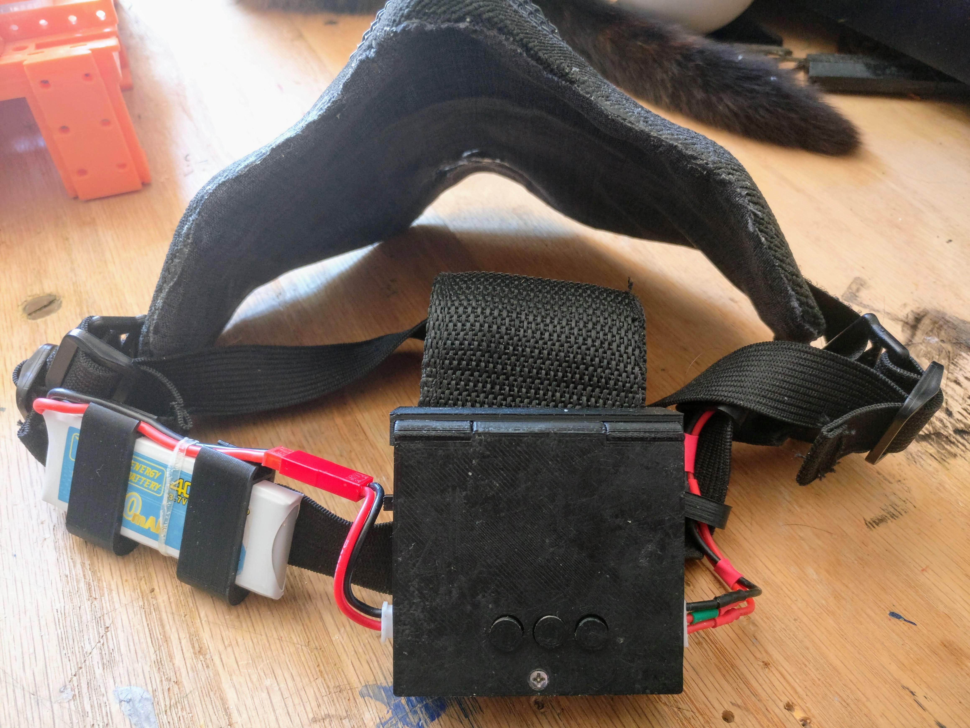
Images/IMG_20200723_155159.jpg
