AlbertGBarber/Pixel-Mask/Images/IMG_20200806_103429.jpg

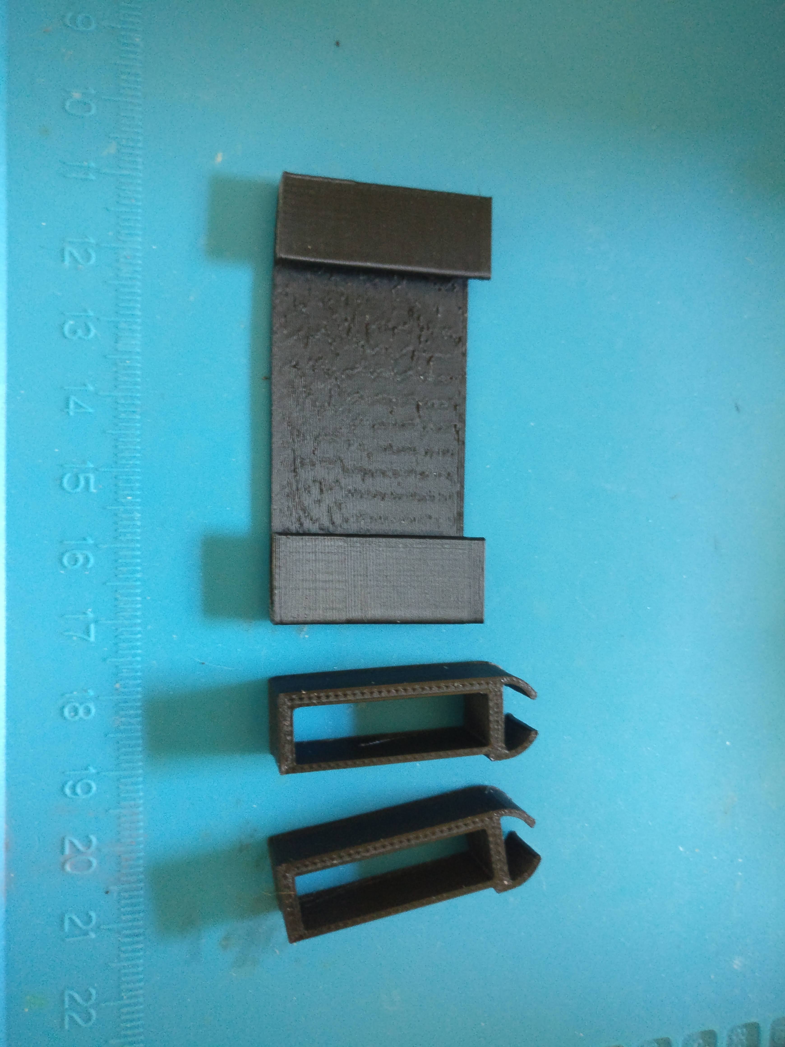
Images/IMG_20200806_103429.jpg
