AlbertGBarber/Pixel-Mask/Images/IMG_20200806_103626.jpg

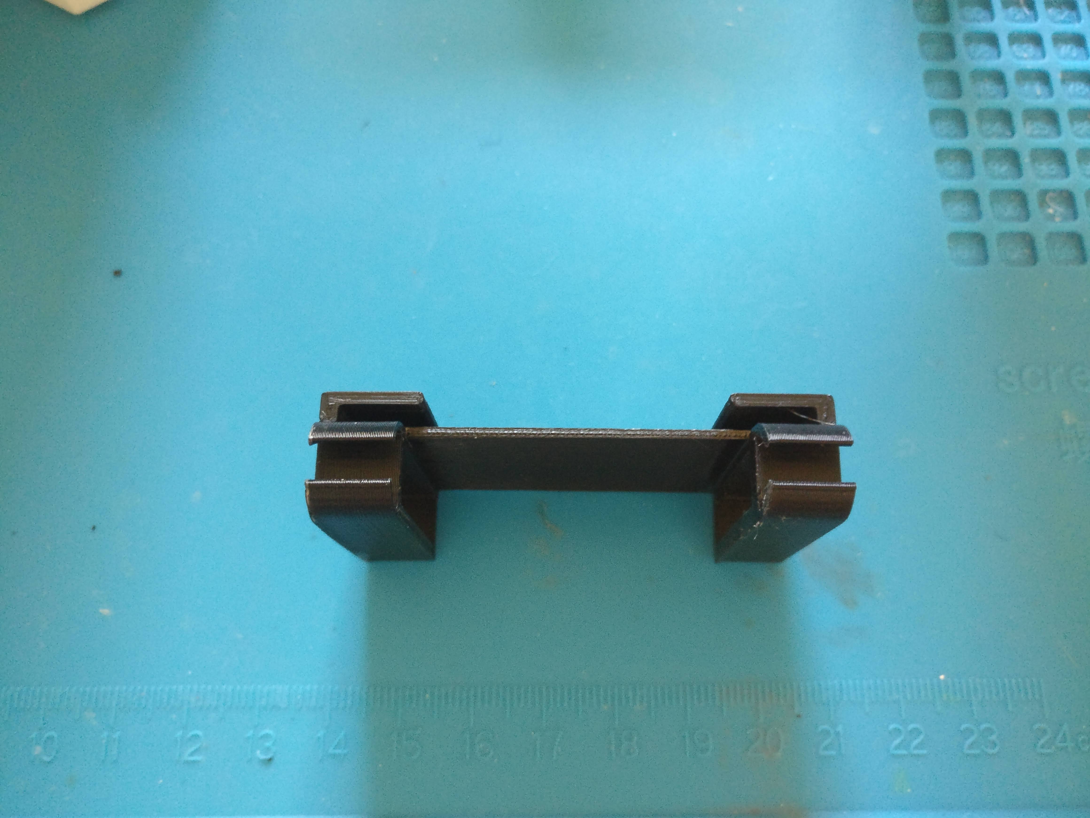
Images/IMG_20200806_103626.jpg
