AlbertGBarber/Pixel-Mask/Images/IMG_20200806_104436.jpg

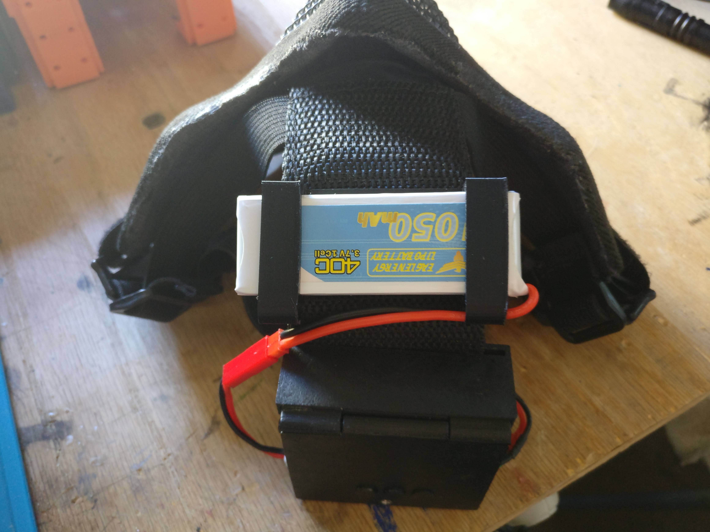
Images/IMG_20200806_104436.jpg
