AlbertGBarber/Pixel-Mask/Images/IMG_20201108_161334.jpg

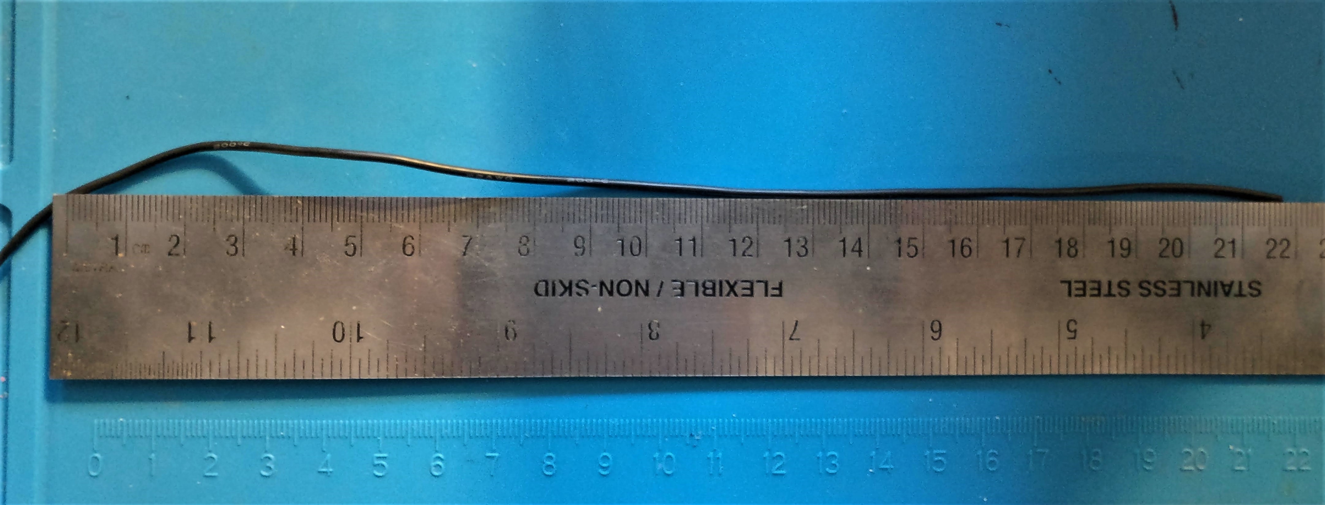
Images/IMG_20201108_161334.jpg
