AlbertGBarber/Pixel-Mask/PCB Ver Stuff and Code (not for Instructable)/PCB Files/BOM_Pixel Mask_2020-10-21_10-26-01.csv

ID | Name | Designator | Footprint | Quantity | Manufacturer Part | Manufacturer | Supplier | Supplier Part | LCSC Assembly
1 | 1N4148W_C81598 | D2,D1 | SOD-123_L2.8-W1.8-LS3.7-RD | 2 | 1N4148W | SEMTECH | LCSC | C81598 | Yes
2 | Header-Male-2.54_1x3 | P1,P2 | HDR-TH_3P-P2.54-V | 2 | Header2.54mm 1*3P | BOOMELE | LCSC | C49257
3 | HDR-M-2.54_1x3 | J1,J2 | HDR-M-2.54_1X3 | 2 |  |  | LCSC | C180248
4 | 0.1u | C2,C1,C43,C44,C45,C46,C47,C52,C51,C50,C49,C48,C33,C34,C35,C36,C37,C42,C41,C40,C39,C38,C23,C24,C25,C26,C27,C32,C31,C30,C29,C28,C13,C14,C15,C16,C17,C22,C21,C20,C19,C18,C8,C9,C10,C11,C12,C7,C6,C5,C4,C3,C55,C56,C57,C58,C59,C64,C63,C62,C61,C60,C70,C71,C72,C73,C74,C69,C68,C67,C66,C65,C80,C81,C82,C83,C84,C79,C78,C77,C76,C75,C90,C91,C92,C93,C94,C89,C88,C87,C86,C85,C100,C101,C102,C103,C104,C99,C98,C97,C96,C95,C53,C54 | C0402 | 104 | CL05B104KO5NNNC | SAMSUNG | LCSC | C1525
5 | WS2812E | 43,44,45,46,47,52,51,50,49,48,33,34,35,36,37,42,41,40,39,38,23,24,25,26,27,32,31,30,29,28,13,14,15,16,17,22,21,20,19,18,8,9,10,11,12,7,6,5,4,3,2,1,53,54,55,56,57,58,59,64,63,62,61,60,70,71,72,73,74,69,68,67,66,65,80,81,82,83,84,79,78,77,76,75,90,91,92,93,94,89,88,87,86,85,100,101,102,103,104,99,98,97,96,95 | LED-5050_4P | 104 | WS2812C | Worldsemi | LCSC | C114587 | Yes
