AlbertGBarber/Pixel-Mask/3D Printed Parts/Battery Rear Strap Mount pt 2.stl

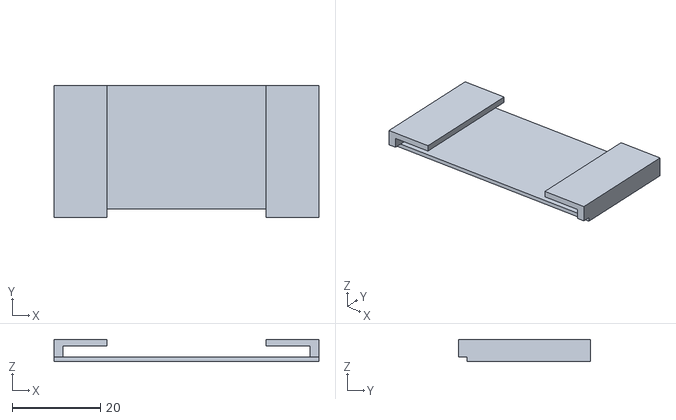
[picture p53: CAD file, 2020-08-06]
3D Printed Parts/Battery Rear Strap Mount pt 2.stl
60.0 x 30.0 x 5.00
