AlbertGBarber/Pixel-Mask/3D Printed Parts/Box V2/Box.stl

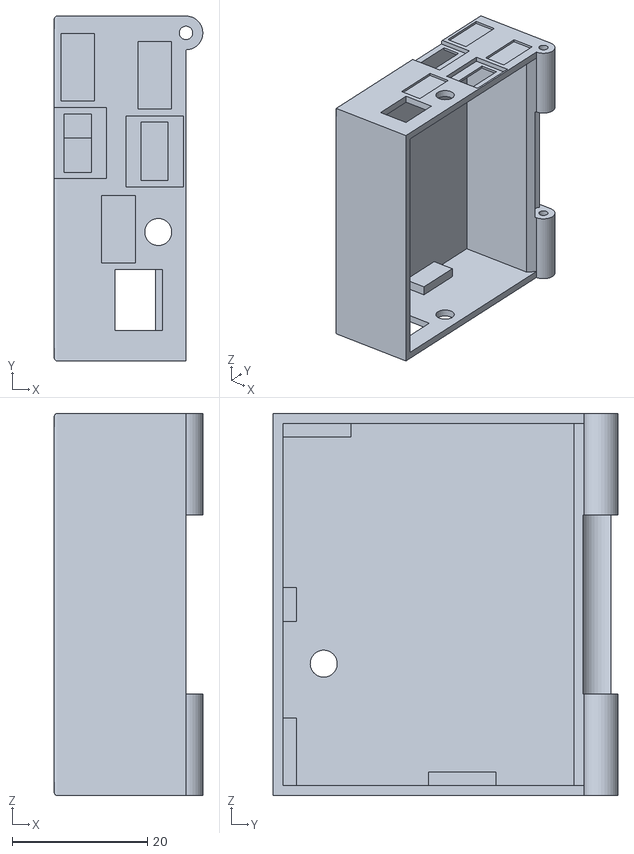
[picture p54: CAD file, 2020-12-05]
3D Printed Parts/Box V2/Box.stl
22.0 x 51.0 x 56.5
