AlbertGBarber/Pixel-Mask/PCB Ver Stuff and Code (not for Instructable)/PCB Files/PCB_pixel_layout.dxf

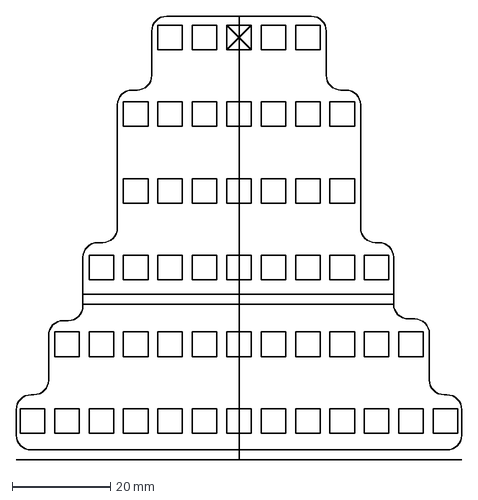
[picture p55: CAD file, 2020-07-08]
PCB Ver Stuff and Code (not for Instructable)/PCB Files/PCB_pixel_layout.dxf
90.6 x 90.2 mm
