AlbertGBarber/Pixel-Mask/3D Printed Parts/Battery Rear Strap Mount pt 1.stl

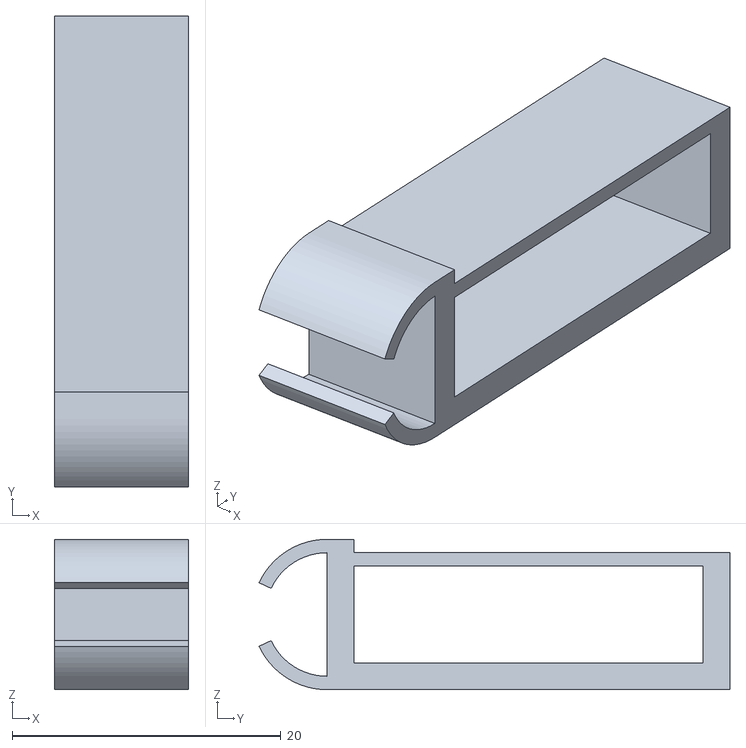
[picture p56: CAD file, 2020-08-06]
3D Printed Parts/Battery Rear Strap Mount pt 1.stl
10.0 x 35.1 x 11.2
