AlbertGBarber/Pixel-Mask/3D Printed Parts/Box V2/Button Cap.stl

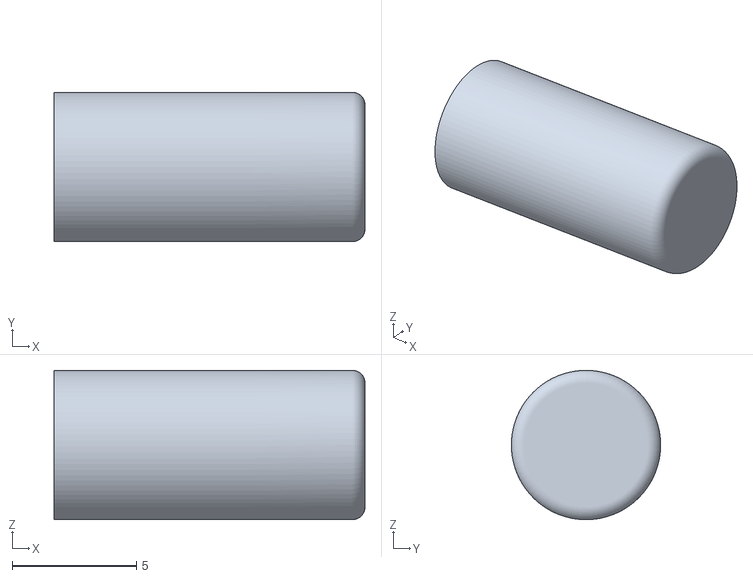
[picture p57: CAD file, 2020-12-03]
3D Printed Parts/Box V2/Button Cap.stl
12.5 x 6.00 x 6.00
