AlbertGBarber/Pixel-Mask/3D Printed Parts/Box V2/Switch Cap.stl

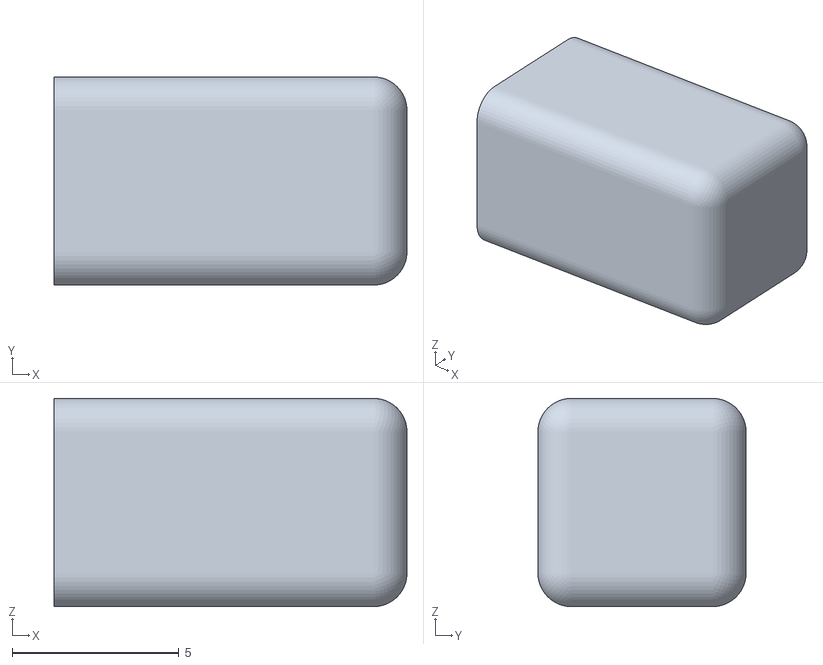
[picture p58: CAD file, 2020-11-09]
3D Printed Parts/Box V2/Switch Cap.stl
10.6 x 6.25 x 6.25
