AlbertGBarber/Pixel-Mask/3D Printed Parts/Wemos Box Strap Mount.stl

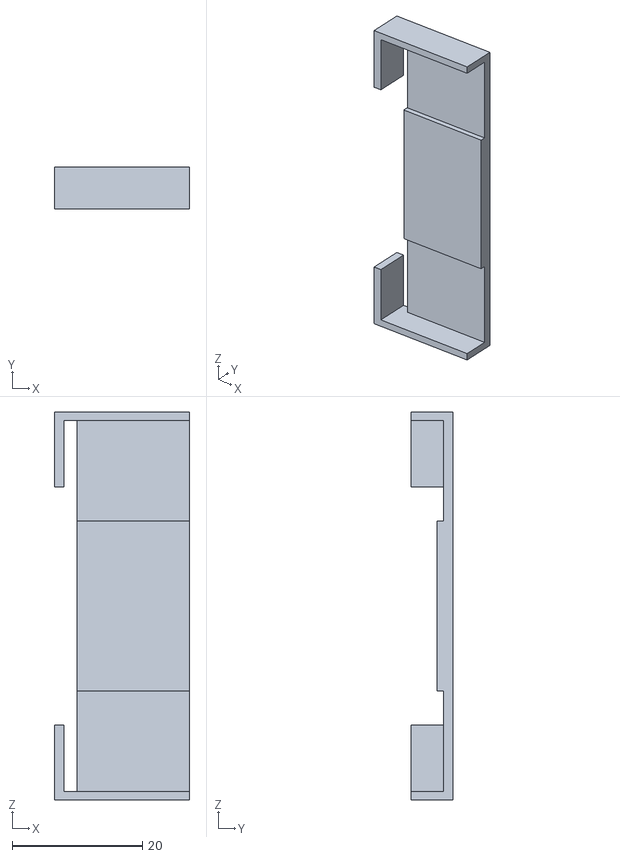
[picture p59: CAD file, 2020-07-08]
3D Printed Parts/Wemos Box Strap Mount.stl
20.8 x 6.50 x 59.5
