AlbertGBarber/Pixel-Mask/3D Printed Parts/Box V2/Lid.stl

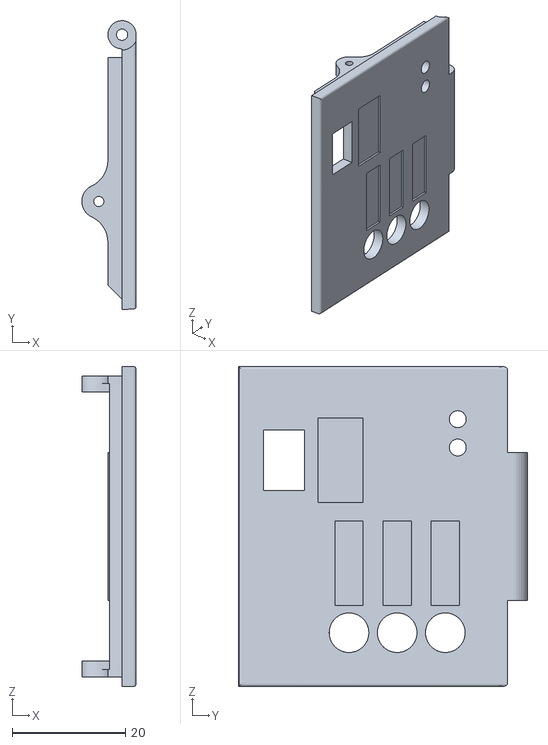
[picture p60: CAD file, 2020-11-09]
3D Printed Parts/Box V2/Lid.stl
9.60 x 51.0 x 56.5
