AlbertGBarber/Pixel-Mask/3D Printed Parts/Strap Cable Guide.stl

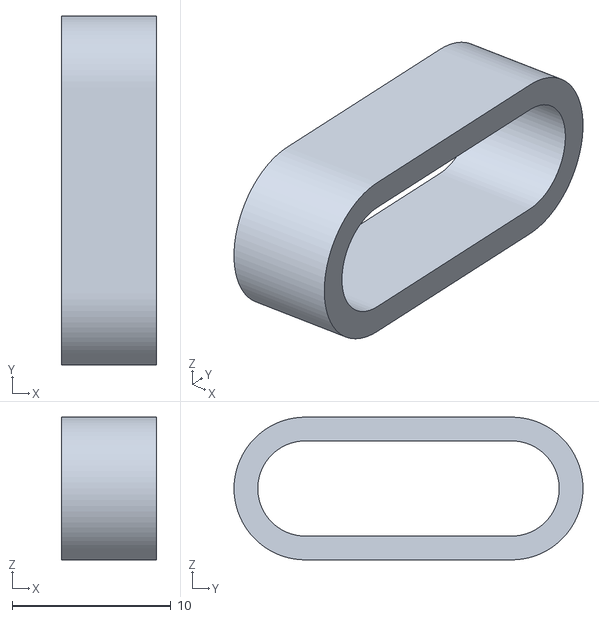
[picture p61: CAD file, 2020-07-08]
3D Printed Parts/Strap Cable Guide.stl
6.00 x 22.0 x 9.00
