AlbertGBarber/Pixel-Mask/3D Printed Parts/Battery Strap Mount V2.stl

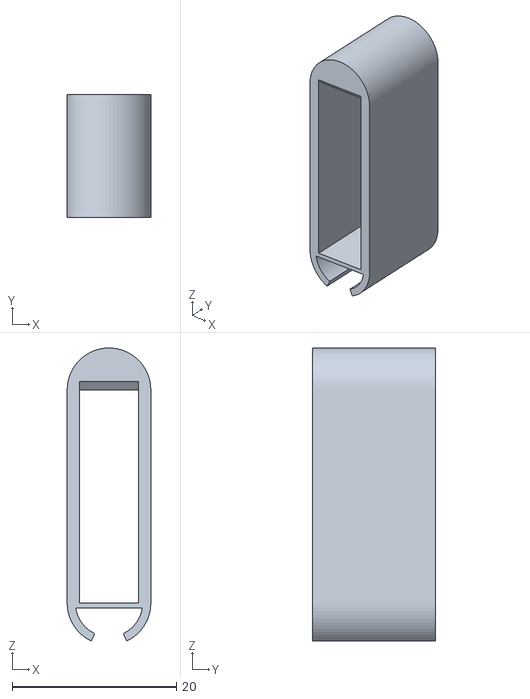
[picture p62: CAD file, 2020-07-08]
3D Printed Parts/Battery Strap Mount V2.stl
10.2 x 15.0 x 35.7
