AlbertGBarber/Pixel-Mask/3D Printed Parts/Box V1/Box.stl

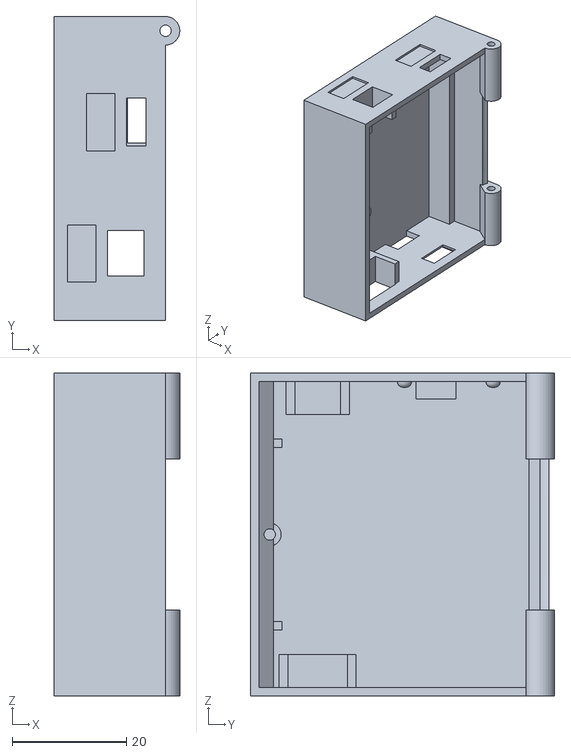
[picture p63: CAD file, 2020-07-08, an earlier design]
3D Printed Parts/Box V1/Box.stl
22.0 x 53.2 x 56.5
