AlbertGBarber/Pixel-Mask/3D Printed Parts/Box V1/Lid.stl

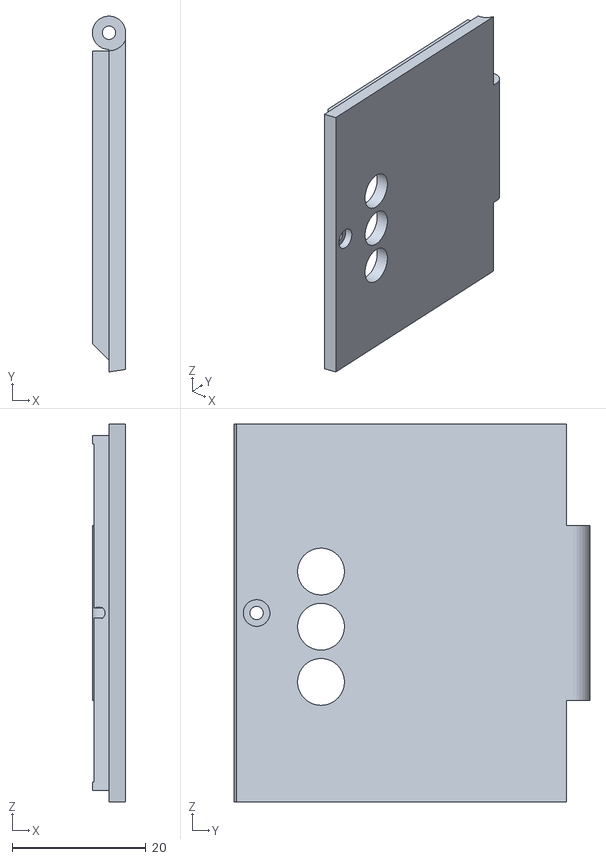
[picture p64: CAD file, 2020-07-08, an earlier design]
3D Printed Parts/Box V1/Lid.stl
5.00 x 53.2 x 56.5
