AlbertGBarber/Pixel-Mask/3D Printed Parts/Box V1/button.stl

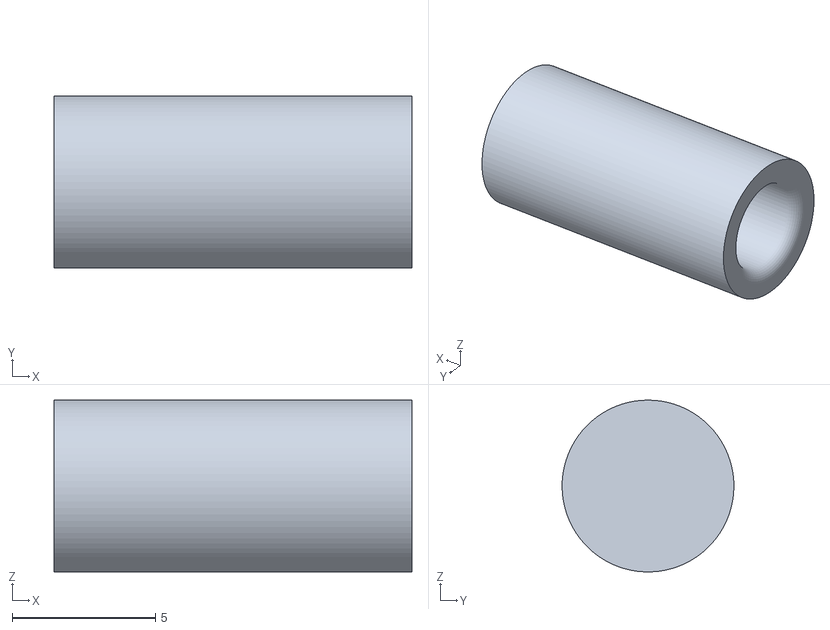
[picture p65: CAD file, 2020-07-08, an earlier design]
3D Printed Parts/Box V1/button.stl
12.5 x 6.00 x 6.00
