AlbertGBarber/Pixel-Mask/PCB Ver Stuff and Code (not for Instructable)/PCB Pixel Layout.xlsx

 |  |  |  |  | Mask | Top / Front
 |  |  |  |  | 51 | 52
 |  |  |  | 28 | 50 | 53 | 75
 |  |  | 27 | 29 | 49 | 54 | 74 | 76
 | 11 | 12 | 26 | 30 | 48 | 55 | 73 | 77 | 91 | 92
0 | 10 | 13 | 25 | 31 | 47 | 56 | 72 | 78 | 90 | 93 | 103
1 | 9 | 14 | 24 | 32 | 46 | 57 | 71 | 79 | 89 | 94 | 102
2 | 8 | 15 | 23 | 33 | 45 | 58 | 70 | 80 | 88 | 95 | 101
3 | 7 | 16 | 22 | 34 | 44 | 59 | 69 | 81 | 87 | 96 | 100
4 | 6 | 17 | 21 | 35 | 43 | 60 | 68 | 82 | 86 | 97 | 99
 | 5 | 18 | 20 | 36 | 42 | 61 | 67 | 83 | 85 | 98
 |  |  | 19 | 37 | 41 | 62 | 66 | 84
 |  |  |  | 38 | 40 | 63 | 65
 |  |  |  |  | 39 | 64
