AlbertGBarber/Pixel-Mask/Pixel_Mask_Code_Halloween/Pixel_Mask_Code_Halloween.ino

//This code is placed under the MIT license
//Copyright (c) 2020 Albert Barber
//
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
//code intended to run on esp8266, Wemos D1 mini
//requires lastest version of adafruit neopixel library (use the library manager)
#include <PixelStrip.h>
#include "segmentDefs.h"
#include <EEPROM.h>
#include <Ticker.h>

//pin connections
#define PIXEL_PIN       D8
#define BUTTON_1        D6
#define BUTTON_2        D7
#define BUTTON_3        D5

//below vars are placeholders for possible bluetooth and mic board connections
#define MIC_IN          A0
#define RX_BT           D1
#define TX_BT           D2

//EEPROM Addresses for settings
//we want to store the brightness, current effect index, and the effect rotation toggle
//so they can be recalled after the mask has been turned off
#define BRIGHTNESS_ADDR 2 //brightness address
#define CUR_EFFECT_ADDR 0 //index of current effect address
#define EFFECT_ROT_ADDR 1 //effect rotaion bool address
#define EEPROM_COM_TIME 3000 //ms

//effects control vars
byte effectIndex = 0; //number of effect that's currently active (will be read from EEPROM later)
const byte numEffects = 41; //number of current effects - 1
boolean effectRota = true; //effects rotation on / off flag
boolean effectsStop = false; //stop all effects flag
boolean direct = true; //use for setting direction of effects
boolean breakCurrentEffect = false; //flag for breaking out of effects that use multiple sub effects / loops

//macro for implementing break for effects with multiple sub effects
#define breakEffectCheck() ({ \
    if( (breakCurrentEffect) ){ \
      (breakCurrentEffect) = false; \
      break; \
    } \
  })

//brightness vars
byte brightnessIndex = 1; //initial brightness, index of brightnessLevels array
//brightness levels array, max is 255, but 100 should be bright enough for amost all cases
//!!WARNING brightness is directly tied to power consumption, the max current per led is 60ma, this is for white at 255 brightness
//if you actually run all the leds at max, the glasses will draw 4.75 amps, this is beyond the rating of the jst connectors
const byte brightnessLevels[] = { 30, 50, 150, 230 };
const byte numBrightnessLevels = SIZE( brightnessLevels );

//Strip definitions
const uint16_t stripLength = 104;
const uint8_t stripType = NEO_GRB + NEO_KHZ800;
PixelStrip strip = PixelStrip(stripLength, PIXEL_PIN, stripType);

//initilize ticker objects
Ticker EEPROMcommiter; //timer for commiting data to EEPRROM

//Define some colors we'll use frequently
const uint32_t white =    strip.Color(255, 255, 255);
const uint32_t off =      strip.Color( 0, 0, 0 );
const uint32_t red =      strip.Color(255, 0, 0);
const uint32_t ltOrange = strip.Color(255, 143, 0);
const uint32_t ltYellow = strip.Color(255, 255, 100);
const uint32_t purple =   strip.Color(123, 7, 197);
const uint32_t pink =     strip.Color(225, 0, 127);

const uint32_t orangeHalwen = strip.Color(250, 65, 19); //strip.Color(253,119,8);
const uint32_t yellowHalwen = strip.Color(253, 229, 0);
const uint32_t greenHalwen = strip.Color( 43, 208, 17 );
const uint32_t purpleHalwen = strip.Color(174, 3, 255); //strip.Color(137,41,191);
const uint32_t blueHalwen = strip.Color( 16, 124, 126 );
const uint32_t brownOrangHalwen = strip.Color(92, 16, 9);

const uint32_t pastelRainbow = strip.Color(130, 185, 226); //178,231,254,
const uint32_t pastelRainbow1 = strip.Color(110, 46, 145); //purple
const uint32_t pastelRainbow2 = strip.Color(54, 174, 218); //teal
const uint32_t pastelRainbow3 = strip.Color(120, 212, 96); //green
const uint32_t pastelRainbow4 = strip.Color(255, 254, 188); //yellow
const uint32_t pastelRainbow5 = strip.Color(236, 116, 70); //orange
const uint32_t pastelRainbow6 = strip.Color(229, 61, 84); //pink red

//define pallet array, contains 32bit representations of all colors used in patterns
uint32_t pallet[9] = { off, white };
//                   { -0-, --1-- }

uint32_t halloweenPallet[] = { greenHalwen, purpleHalwen, orangeHalwen, brownOrangHalwen, off };
//                              -----0-----  ------1-----  -----2------  ------3----      -4--

//removes the off
uint32_t halloweenSubPallet[] = { greenHalwen, purpleHalwen, orangeHalwen, brownOrangHalwen };
//                                 -----0-----  ------1-----  -----2------   ------3----

byte halloweenWavePattern[4] = { 0, 1, 2, 3 };


uint32_t pastelRainbowPallet[] = { pastelRainbow, pastelRainbow1 , pastelRainbow2, pastelRainbow3, pastelRainbow4, pastelRainbow5, pastelRainbow6 };
byte pastelRainbowPattern[] = {  6, 6, 1, 1, 2, 2, 5, 5, 4, 4, 3, 3, 0, 0 };

uint32_t firePallet[3] = { red, ltOrange, ltYellow };

uint32_t firePallet2[3] = { purple, pink, white };

uint32_t firePallet3[3] = { blueHalwen, greenHalwen, pastelRainbow3};
//byte wavepattern[]  = { 6, 1 };
//byte wavepattern2[] = { 5, 4 };
//byte wavepattern3[] = { 6, 7 };
//byte wavepattern4[] = { 8, 7 };
//byte christmasWavePattern[5] = { 0, 1, 2, 3, 4};

//below are spin patterns
//these are for use with the colorSpin function, which draws a pattern across segments (using the longest segment as the pattern basis)
//and then moves it along the longest segment
//you can make your own, their structure is the following
//(note that you'll have to understand how segments work in my library, you can find notes on segments in segmentSet.h)
//a spin pattern is comprised of two parts combined into one 1d array
// { 0, 1,   1, 2, 0, 0, 0, }
//  part 1       part 2
//part 1 indicates the leds on the longest segment that part 2 is to be drawn on (doesn't inculde the last index, so 1 above wouldn't be drawn)
//part 2 is the pattern of colors for each segment, made up of indeces for at pallet (ie 1 represents the second color in the pallet)

//this is confusing so I'll give an example
//for the glasses, using lenseRowSegments (each row of the glasses is a segment, excluding the center 6 leds so that all the rows are the same length)
//part 1 above indicates that, from the 0th led of the first segment, up to (not including) the 1st led, the color pattern of the segments is part 2
//the result is that the first led of each row are colored (using pallet above) row 0 -> white, row 1 -> uclaGold, row 2 -> off,  row 3 -> off, row 4 -> off
//note that leds indexs in part 1 are always defined using the longest segment, because colorSpin will map the pattern (part 1) onto shorter segments
//this works well on most led arrangments, but not so much on the glasses
//which is why I'm using lenseRowSegments, so that all segments are equal length, and the mapping is one to one

//as below, spin patterns can have multiple pattern sections
//you define the matrix as: spinPatternName[(5 + 2) * 8] -> [ (number of segments + 2) * number of rows in pattern ]
//you can also make patterns repeat using colorSpin, so you just have to define a single complete pattern (like I do with spinPatternWave)

//rowCenSegments
//two color sine wave pattern
byte spinPatternWave[(7 + 2) * 10] = {
  0, 1,   1, 2, 0, 0, 0, 0, 0,
  1, 2,   3, 1, 2, 0, 0, 0, 0,
  2, 3,   0, 3, 1, 2, 0, 0, 0,
  3, 4,   0, 0, 3, 1, 2, 0, 0,
  4, 5,   0, 0, 0, 3, 1, 2, 0,
  5, 6,   0, 0, 0, 0, 3, 1, 2,
  6, 7,   0, 0, 0, 3, 1, 2, 0,
  7, 8,   0, 0, 3, 1, 2, 0, 0,
  8, 9,   0, 3, 1, 2, 0, 0, 0,
  9, 10,  3, 1, 2, 0, 0, 0, 0,
};

//rowCenSegments
//two color sine wave pattern
byte spinPatternWave2[(7 + 2) * 8] = {
  0, 1,   0, 1, 2, 1, 0, 0, 0,
  1, 2,   0, 0, 1, 2, 1, 0, 0,
  2, 3,   0, 0, 0, 1, 2, 1, 0,
  3, 4,   0, 0, 0, 0, 1, 2, 1,
  4, 5,   0, 0, 0, 0, 1, 2, 1,
  5, 6,   0, 0, 0, 1, 2, 1, 0,
  6, 7,   0, 0, 1, 2, 1, 0, 0,
  7, 8,   0, 1, 2, 1, 0, 0, 0,
};

//rowCenSegments
//two color sine wave pattern
byte spinPatternHeart[(7 + 2) * 7] = {
  0, 1,   0, 0, 0, 0, 0, 0, 0,
  1, 2,   0, 0, 1, 1, 1, 0, 0,
  2, 3,   0, 1, 2, 2, 2, 1, 0,
  3, 4,   0, 0, 1, 2, 2, 2, 1,
  4, 5,   0, 1, 2, 2, 2, 1, 0,
  5, 6,   0, 0, 1, 1, 1, 0, 0,
  6, 7,   0, 0, 0, 0, 0, 0, 0,
};

//rowCenSegments
//two color sine wave pattern
byte spinPatternHelix[(7 + 2) * 10] = {
  0, 1,   0, 1, 0, 0, 0, 2, 0,
  1, 2,   0, 0, 1, 0, 2, 0, 0,
  2, 3,   0, 0, 0, 1, 0, 0, 0,
  3, 4,   0, 0, 2, 0, 1, 0, 0,
  4, 5,   0, 2, 0, 0, 0, 1, 0,
  5, 6,   0, 2, 0, 0, 0, 1, 0,
  6, 7,   0, 0, 2, 0, 1, 0, 0,
  7, 8,   0, 0, 0, 2, 0, 0, 0,
  8, 9,   0, 0, 1, 0, 2, 0, 0,
  9, 10,  0, 1, 0, 0, 0, 2, 0,
};

//for rowHalfCenSegments, we want rows seperated, so we can move the arrows in opposite directions
//two color arrows, moving horizontally
//if you want vertical arrows, you have to use columnSegments
byte spinPatternArrows[(14 + 2) * 5] = {
  0, 1,  1, 0, 0, 0, 0, 0, 1, 1, 0, 0, 0, 0, 0, 1,
  1, 2,  2, 1, 0, 0, 0, 1, 2, 2, 1, 0, 0, 0, 1, 2,
  2, 3,  0, 2, 1, 0, 1, 2, 0, 0, 2, 1, 0, 1, 2, 0,
  3, 4,  0, 0, 2, 1, 2, 0, 0, 0, 0, 2, 1, 2, 0, 0,
  4, 5,  0, 0, 0, 2, 0, 0, 0, 0, 0, 0, 2, 0, 0, 0,
};

byte spinPatternArrows2[(14 + 2) * 5] = {
  0, 1,  1, 1, 1, 0, 1, 1, 1, 1, 1, 1, 0, 1, 1, 1,
  1, 2,  2, 1, 1, 1, 1, 1, 2, 2, 1, 1, 0, 1, 1, 2,
  2, 3,  2, 2, 1, 1, 1, 2, 2, 2, 2, 1, 1, 1, 2, 2,
  3, 4,  0, 2, 2, 1, 2, 2, 0, 0, 2, 2, 1, 2, 2, 0,
  4, 5,  1, 0, 2, 2, 2, 0, 1, 1, 0, 2, 2, 2, 0, 1,
};

//for rowHalfCenSegments, we want rows seperated, so we can move the arrows in opposite directions
byte spinPatternCircles[(14 + 2) * 4] = {
  0, 1,  2, 1, 0, 0, 0, 1, 2, 2, 1, 0, 0, 0, 1, 2,
  1, 2,  0, 2, 1, 1, 1, 2, 0, 0, 2, 1, 1, 1, 2, 0,
  2, 3,  0, 0, 2, 2, 2, 0, 0, 0, 0, 2, 2, 2, 0, 0,
  3, 4,  0, 0, 0, 0, 0, 0, 0, 0, 0, 0, 0, 0, 0, 0,
};

//for rowHalfCenSegments, we want rows seperated, so we can move the arrows in opposite directions
byte spinPatternX[(14 + 2) * 4] = {
  0, 1,  0, 0, 1, 2, 1, 0, 0, 0, 0, 1, 2, 1, 0, 0,
  1, 2,  0, 1, 2, 0, 2, 1, 0, 0, 1, 2, 0, 2, 1, 0,
  2, 3,  1, 2, 0, 0, 0, 2, 1, 1, 2, 0, 0, 0, 2, 1,
  3, 4,  2, 0, 0, 0, 0, 0, 2, 2, 0, 0, 0, 0, 0, 2,
};

//for colCenSegments, vertical arrows
byte spinPatternArrowsVert[(12 + 2) * 4] = {
  0, 1,   3, 4, 1, 2, 3, 4, 4, 3, 2, 1, 4, 3,
  1, 2,   2, 3, 4, 1, 2, 3, 3, 2, 1, 4, 3, 2,
  2, 3,   1, 2, 3, 4, 1, 2, 2, 1, 4, 3, 2, 1,
  3, 4,   4, 1, 2, 3, 4, 1, 1, 4, 3, 2, 1, 4,
};

//for colCenSegments, vertical arrows
byte spinPatternArrowsVert2[(12 + 2) * 6] = {
  0, 1,   0, 2, 2, 3, 3, 0, 0, 3, 3, 2, 2, 0,
  1, 2,   0, 0, 2, 2, 3, 3, 3, 3, 2, 2, 0, 0,
  2, 3,   3, 0, 0, 2, 2, 3, 3, 2, 2, 0, 0, 3,
  3, 4,   3, 3, 0, 0, 2, 2, 2, 2, 0, 0, 3, 3,
  4, 5,   2, 3, 3, 0, 0, 2, 2, 0, 0, 3, 3, 2,
  5, 6,   2, 2, 3, 3, 0, 0, 0, 0, 3, 3, 2, 2,
};

//for  rowCenSegments, USA flag
byte spinPatternUSflag[(7 + 2) * 5] = {
  0, 1,   4, 1, 4, 1, 6, 1, 6,
  1, 2,   1, 4, 1, 4, 6, 1, 6,
  2, 3,   4, 1, 4, 1, 6, 1, 6,
  3, 4,   1, 4, 1, 4, 6, 1, 6,
  4, 8,   6, 1, 6, 1, 6, 1, 6
};

//for  rowCenSegments, St George's cross (can't get blue right for Union Jack)
byte spinPatternStGeorgeCross[(7 + 2) * 3] = {
  0, 3,   1, 1, 1, 6, 1, 1, 1,
  3, 4,   6, 6, 6, 6, 6, 6, 6,
  4, 7,   1, 1, 1, 6, 1, 1, 1,
};

//storage for pallets we'll generate on the fly
uint32_t tempRandPallet[5]; //pallet for random colors (length sets number of colors used by randomColors effect)
uint32_t tempTwinklePallet[2]; //used for twinkle effect, we are only twinkling two colors at a time

//callback routine for committing EEPROM data
//EEPRROM has limited writes, so we want to commit all the writes after a delay
//this allows the data to change while the user is pressing buttons, and we'll only commit
//the final values once they are done
void ICACHE_RAM_ATTR commitEEPROM() {
  EEPROM.commit();
}

//triggered by button 1, stops the current pattern, and switches to the next one, wrapping if needed
//also stores effect index in eeprom
//if button 2 is also being held, turn effects on / off
void ICACHE_RAM_ATTR nextEffect() {
  strip.pixelStripStopPattern = true; //stop the current pattern
  breakCurrentEffect = true; //set flag to break out of current case statement
  //if we are rotating to the next effect, reset all the segment directions
  //and store the next effect index in eeprom
  if (effectRota) {
    resetSegDirections();
    EEPROM.write(CUR_EFFECT_ADDR, (effectIndex + 1) % numEffects);
    //stop any other commit timers and start a new one
    EEPROMcommiter.detach();
    EEPROMcommiter.once_ms(EEPROM_COM_TIME, commitEEPROM);
  }
  //if button 2 is being held, stop/start the effect cycle
  //otherwise increase the index to start the next effect
  if ( digitalRead(BUTTON_2) == LOW) {
    effectsStop = !effectsStop;
  }
}

//triggered by button 2, turns effect rotation on / off
//also stores the state in eeprom
//(if rotation is off, the current effect will be repeated continuously)
//if button 1 is also being held, turn effects on / off
void ICACHE_RAM_ATTR effectRotaToggle() {
  if ( digitalRead(BUTTON_1) == LOW) {
    strip.pixelStripStopPattern = true;
    effectsStop = !effectsStop;
  } else {
    effectRota = !effectRota;
    EEPROM.write(EFFECT_ROT_ADDR, effectRota);
    //stop any other commit timers and start a new one
    EEPROMcommiter.detach();
    EEPROMcommiter.once_ms(EEPROM_COM_TIME, commitEEPROM);
  }
}

//triggered by button 3, sets the strip brightness to the next
//also stores the brighness index in eeprom
//brightness level in the brightnessLevels array (wrapping to the start if needed)
void ICACHE_RAM_ATTR brightnessAdjust() {
  brightnessIndex = (brightnessIndex + 1) % numBrightnessLevels;
  strip.setBrightness( brightnessLevels[ brightnessIndex ] );
  EEPROM.write(BRIGHTNESS_ADDR, brightnessIndex);
  //stop any other commit timers and start a new one
  EEPROMcommiter.detach();
  EEPROMcommiter.once_ms(EEPROM_COM_TIME, commitEEPROM);
}

//increments the effect index (wrapping if needed)
void incrementEffectIndex() {
  resetSegDirections();
  strip.runRainbowOffsetCycle(false);
  strip.setRainbowOffset(0);
  effectIndex = (effectIndex + 1) % numEffects;
}

//resets all the segments to their default directions (as set in segmentDefs)
void resetSegDirections() {
  colSegments.setsegDirectionEvery(2, true, true);
  colSegments.setsegDirectionEvery(2, false, false);

  colHalfSegments.setsegDirectionEvery(2, false, true);
  colHalfSegments.setsegDirectionEvery(2, true, false);

  colHalfFlipSegments.setsegDirectionEvery(1, true, true);

  colCenSegments.setsegDirectionEvery(2, true, true);
  colCenSegments.setsegDirectionEvery(2, false, false);

  rowSegments.setsegDirectionEvery(1, true, true);

  rowHalfSegments.setsegDirectionEvery(2, false, true);
  rowHalfSegments.setsegDirectionEvery(2, true, false);
}

void setup() {
  //initalize the led strip, and set the starting brightness
  strip.begin();

  pinMode(BUTTON_1, INPUT_PULLUP);
  pinMode(BUTTON_2, INPUT_PULLUP);
  pinMode(BUTTON_3, INPUT_PULLUP);
  //because of the way my library currently works, effects occupy the processor until they end
  //so to break out of an effect, or change sytem values, we need to use interrupts
  attachInterrupt(digitalPinToInterrupt(BUTTON_1), nextEffect, FALLING);
  attachInterrupt(digitalPinToInterrupt(BUTTON_2), effectRotaToggle, FALLING);
  attachInterrupt(digitalPinToInterrupt(BUTTON_3), brightnessAdjust, FALLING);

  // EEPROM Initialization
  EEPROM.begin(512);

  //read EEPROM values for current effect, brightness, and effect rotation
  effectRota = EEPROM.read(EFFECT_ROT_ADDR);
  brightnessIndex = EEPROM.read(BRIGHTNESS_ADDR);
  effectIndex = EEPROM.read(CUR_EFFECT_ADDR);

  strip.setBrightness( brightnessLevels[brightnessIndex] );
  strip.show();
  //Serial.begin(115200);

  randomSeed(ESP.getCycleCount()); //generate a random seed
  //fill in our random pallet
  strip.genRandPallet( tempRandPallet, SIZE(tempRandPallet) );
}

//!! If you want to change the main loop code, please read all the comments below and in the loop !!
//To remove an effect, simply change its case # to anything greater than the total number of effects (999 for ex)
//if you want to know about certain effects, please see comments in the library for said effect
//if you want to know how segments work, please see comments in segmentSet.h

//The main loop of the program, works as follows:
//if effectsStop is true, effects are "off", so we won't try to start the next effect
//otherwise we jump to the effect matching the effectIndex value using a switch statment
//we also "clean up" a bit by reseting direct to true and the breakCurrentEffect flag to false
//if we don't find an effect with the effectIndex, we increment the effectIndex until we do
//while an effect is running, button inputs can either lock the effect or skip to the next effect
//if we lock the effect (set effectRota to false), we do not increment effectIndex when the effect ends, essentially restarting the effect (with new colors if they're randomly choosen)
//if the effect is skipped, we set strip.pixelStripStopPattern and breakCurrentEffect to true
//strip.pixelStripStopPattern will stop the current effect, and breakCurrentEffect will break out of the current switch statement if needed (the switch case has more than one effect)
//once the effect ends (either naturally or from a button press), we incremented effectIndex (as long as effectRota is set true)
//and jump to the top of the main loop

void loop() {

  if (!effectsStop) { //if effectsStop is true, we won't display any effect
    direct = true;
    breakCurrentEffect = false;
    //switch statment contains all effects
    //I'm not going to comment each one, as they're hard to describe
    //if an case has a loop, it generally means the effect will by run multiple times in diff directions
    //these will contain breakEffectCheck(); which will breakout of the case if the effect is skipped by button input
    //segmentName.flipSegDirectionEvery(1, true) means that the direction of the names segments will be reversed
    //this is used to change the direction of colorSpin effects

    switch (effectIndex) { //select the next effect based on the effectIndex
      case 0:
        for (int i = 0; i < 4; i++) {
          if (i == 0) {
            tempTwinklePallet[0] = halloweenPallet[0];
            tempTwinklePallet[1] = halloweenPallet[1];
          } else if (i == 1) {
            tempTwinklePallet[0] = halloweenPallet[2];
            tempTwinklePallet[1] = halloweenPallet[0];
          } else if (i == 2) {
            tempTwinklePallet[0] = halloweenPallet[3];
            tempTwinklePallet[1] = halloweenPallet[2];
          } else if (i == 3) {
            tempTwinklePallet[0] = halloweenPallet[0];
            tempTwinklePallet[1] = halloweenPallet[3];
          }
          breakEffectCheck();
          strip.twinkle(tempTwinklePallet[1], tempTwinklePallet[0], 2, 60, 40, 8000);
          //strip.randomColors(tempTwinklePallet[1], false, tempTwinklePallet[0], 120, 15, 12000);
        }
        break;
      case 1:
        strip.shooterSeg( colSegments, halloweenPallet, 3, 0, true, 12, 1, 1, 3, 4, false, false, 60, 170);
        break;
      case 2:
        strip.shooterSeg( colSegments, halloweenPallet, 5, 0, true, 12, 1, 1, 3, 2, false, false, 60, 170); //rainbow
        break;
      case 3:
        //strip.shooterSeg( rowHalfSegments, pallet, 3, 0, true, 10, 1, 1, 3, 4, true, false, 70, 170);
        break;
      case 4:
        strip.shooterSeg( rowHalfSegments, halloweenPallet, 5, 0, true, 10, 1, 1, 3, 2, true, false, 70, 170); //rainbow
        break;
      case 5:
        strip.shooterSeg( rowHalfSegments, halloweenPallet, 5, 0, true, 8, 1, 3, 3, 1, true, false, 70, 150);
        break;
      case 6:
        strip.shooterSeg( colSegments, halloweenPallet, 5, 0, true, 8, 1, 3, 3, 1, false, false, 70, 150);
        break;
      case 7:
        //strip.shooterSeg( colHalfFlipSegments, pallet, 4, 0, true, 5, 6, 1, 6, 4, true, false, 70, 180);
        break;
      case 8:
        //strip.genRandPallet( tempRandPallet, SIZE(tempRandPallet) );
        //strip.patternSweepSetRand( 9, tempRandPallet,  SIZE(tempRandPallet), 0, 1, 4, true, 0, 1, 60, 200);
        break;
      case 9:
        strip.doFireV2Seg( colSegments, firePallet, SIZE(firePallet), 25, 200, true, 250, 70);
        breakEffectCheck();
        strip.doFireV2Seg( colSegments, firePallet2, SIZE(firePallet2), 25, 200, true, 250, 70);
        breakEffectCheck();
        strip.doFireV2Seg( colSegments, firePallet3, SIZE(firePallet3), 25, 200, true, 250, 70);
        break;
      case 10:
        for (int i = 0; i < 3; i++) {
          breakEffectCheck();
          strip.patternSweepRepeatRand(4, 0, 0, 2, 4, false, false, 0, 0, 1, 55, 120 );
        }
        break;
      case 11:
        for (int i = 0; i < 2; i++) {
          breakEffectCheck();
          strip.gradientCycleRand( 4, 10, 150, direct, 80);
          direct = !direct;
        }
        break;
      case 12:
        for (int i = 0; i < 2; i++) {
          breakEffectCheck();
          strip.genRandPallet( tempRandPallet, SIZE(tempRandPallet) );
          tempRandPallet[0] = 0; //background color for spin patterns (off)
          strip.fillStrip(tempRandPallet[2], false);
          rowCenSegments.flipSegDirectionEvery(1, true);
          strip.colorSpin( rowCenSegments, spinPatternWave2, SIZE(spinPatternWave2), tempRandPallet, 0, 1, true, 100, 100 );
        }
        break;
      case 13:
        strip.sonarWaves(colSegments, halloweenSubPallet, SIZE(halloweenPallet), halloweenWavePattern, SIZE(halloweenWavePattern), 0, 5, colSegments.numSegs - 1, true, false, true, true, 150, 100);
        break;
      case 14:
        strip.sonarWaves(rowSegments, halloweenSubPallet, SIZE(halloweenPallet), halloweenWavePattern, SIZE(halloweenWavePattern), 0, 4, 8, false, true, true, true, 150, 100);
        break;
      case 15:
        //strip.rainbowWave( colSegments, 80, true, 10, 25);
        break;
      case 16:
        strip.rainbowWave( rowSegments, 80, false, 8, 20);
        break;
      case 17:
        //strip.waves( colSegments, pastelRainbowPallet, SIZE(pastelRainbowPallet),  pastelRainbowPattern, SIZE(pastelRainbowPattern), 50, false, 5, 45);
        break;
      case 18:
        for (int i = 0; i < 10; i++) {
          breakEffectCheck();
          strip.colorWipeRandomSeg( colSegments, 2, 2, 7, 90, true, true, true);
          breakEffectCheck();
          strip.colorWipeSeg(colSegments, 0, 7, 90, false, true, true);
        }
        break;
      case 19:
        breakEffectCheck();
        strip.shiftingSea(halloweenPallet, SIZE(halloweenPallet), 30, 1, 2, 300, 50);
        break;                             
      case 20:
        for (int i = 0; i < 2; i++) {
          breakEffectCheck();
          //strip.randomWaves( colSegments, 5, 3, 2, 50, direct, 7, 20);
          direct = !direct;
        }
        break;
      case 21:
        for (int i = 0; i < 2; i++) {
          breakEffectCheck();
          //strip.randomWaves( rowSegments, 4, 2, 2, 50, direct, 7, 20);
          direct = !direct;
        }
        break;
      case 22:
        for (int i = 0; i < 6; i++) {
          breakEffectCheck();
          strip.colorWipeRandomSeg( rowHalfSegments, 2, 2, 0, 130, direct, false, true);
          breakEffectCheck();
          strip.colorWipeSeg(rowHalfSegments, 0, 0, 130, !direct, false, true);
          direct = !direct;
        }
        break;
      case 23:
        for (int i = 0; i < 2; i++) {
          breakEffectCheck();
          //colCenSegments.flipSegDirectionEvery(1, true);
          //strip.genRandPallet( tempRandPallet, SIZE(tempRandPallet) );
          //tempRandPallet[0] = 0; //background color for spin patterns (off)
          //strip.fillStrip(tempRandPallet[2], false);
          //strip.colorSpin( colCenSegments, spinPatternArrowsVert2, SIZE(spinPatternArrowsVert2), tempRandPallet, 0, 1, true, 100, 110 );
        }
        break;
      case 24:
        for (int i = 0; i < 2; i++) {
          breakEffectCheck();
          strip.genRandPallet( tempRandPallet, SIZE(tempRandPallet) );
          tempRandPallet[0] = 0; //background color for spin patterns (off)
          //strip.fillStrip(tempRandPallet[1], false);
          rowHalfCenSegments.flipSegDirectionEvery(1, true); //reverse the direction of each segment of rowLensesHalvesSegments
          //strip.colorSpin( rowHalfCenSegments, spinPatternArrows2, SIZE(spinPatternArrows2), tempRandPallet, 0, 1, true, 100, 100 );
        }
        break;
      case 25:
        for (int i = 0; i < 2; i++) {
          breakEffectCheck();
          strip.genRandPallet( tempRandPallet, SIZE(tempRandPallet) );
          tempRandPallet[0] = 0; //background color for spin patterns (off)
          strip.fillStrip(tempRandPallet[1], false);
          //strip.colorSpin( rowHalfCenSegments, spinPatternX, SIZE(spinPatternX), tempRandPallet, 0, 1, true, 100, 110 );
          rowHalfCenSegments.flipSegDirectionEvery(1, true); //reverse the direction of each segment of rowLensesHalvesSegments
        }
        break;
      case 26:
        for (int i = 0; i < 2; i++) {
          breakEffectCheck();
          strip.genRandPallet( tempRandPallet, SIZE(tempRandPallet) );
          tempRandPallet[0] = 0; //background color for spin patterns (off)
          strip.fillStrip(tempRandPallet[1], false);
          rowHalfCenSegments.flipSegDirectionEvery(1, true); //reverse the direction of each segment of rowLensesHalvesSegments
          strip.colorSpin( rowHalfCenSegments, spinPatternArrows, SIZE(spinPatternArrows), tempRandPallet, 0, 1, true, 100, 110 );
        }
        break;
      case 27:
        //strip.colorSpinSimple( rowHalfSegments, 5, 0, 0, 3, -1, 3, 0, 1, 170, 120 );
        break;
      case 28:
        strip.setRainbowOffsetCycle(40, false);
        strip.runRainbowOffsetCycle(true);
        //strip.colorSpinSimple( rowSegments, 1, 0, 0, 5, 1, 0, 0, 2, 170, 100 ); //rainbow half
        break;
      case 29:
        for (int i = 0; i < 2; i++) {
          breakEffectCheck();
          colHalfSegments.flipSegDirectionEvery(1, true);
          strip.colorSpinSimple( colHalfSegments, 5, 0, 0, 3, -1, 3, 0, 1, 120, 80 );
        }
        break;
      case 30:
        for (int i = 0; i < 2; i++) {
          breakEffectCheck();
          colHalfSegments.flipSegDirectionEvery(1, true);
          //strip.colorSpinSimple( colHalfSegments, 3, 0, 0, 5, -1, 5, 0, 1, 120, 80 );
        }
        break;
      case 31:
        for (int i = 0; i < 2; i++) {
          breakEffectCheck();
          colHalfSegments.flipSegDirectionEvery(1, true);
          //strip.colorSpinSimple( colHalfSegments, 1, 0, 0, 5, -1, 5, 0, 2, 120, 80 );
        }
        break;
      case 32:
        //strip.simpleStreamerRand( 5, 0, 7, 0, 0, true, 160, 80);
        break;
      case 33:
        strip.patternSweepSetRand( 12, halloweenSubPallet, SIZE(halloweenSubPallet), 0, 0, 0, false, 0, 1, 70, 280 );
        break;
      case 34:
        for (int i = 0; i < 4; i++) {
          if (i == 0) {
            tempTwinklePallet[0] = halloweenPallet[0];
            tempTwinklePallet[1] = halloweenPallet[1];
          } else if (i == 1) {
            tempTwinklePallet[0] = halloweenPallet[2];
            tempTwinklePallet[1] = halloweenPallet[0];
          } else if (i == 2) {
            tempTwinklePallet[0] = halloweenPallet[3];
            tempTwinklePallet[1] = halloweenPallet[2];
          } else if (i == 3) {
            tempTwinklePallet[0] = halloweenPallet[3];
            tempTwinklePallet[1] = halloweenPallet[1];
          }
          breakEffectCheck();
          //strip.twinkleSet(0, tempTwinklePallet, SIZE(tempTwinklePallet), 2, 60, 28, 8000);
          strip.randomColorSet(0, true, tempTwinklePallet, SIZE(tempTwinklePallet), 110, 8, 12000);
        }
        break;
      case 35:
        for (int i = 0; i < 2; i++) {
          breakEffectCheck();
          //strip.segGradientCycleRand(rowSegments, 3, 7, 150, direct, 1, 100);
          direct = !direct;
        }
        break;
      case 36:
        breakEffectCheck();
        strip.segGradientCycle(colSegments, halloweenWavePattern, SIZE(halloweenWavePattern), halloweenPallet, SIZE( halloweenPallet ), 4, 100, true, 130);
        break;
      case 37:
        strip.genRandPallet( tempRandPallet, SIZE(tempRandPallet) );
        tempRandPallet[0] = 0; //background color for spin patterns (off)
        for (int i = 0; i < 2; i++) {
          breakEffectCheck();
          rowCenSegments.flipSegDirectionEvery(1, true);
          //strip.colorSpin( rowCenSegments, spinPatternHelix, SIZE(spinPatternHelix), tempRandPallet, 0, 1, true, 100, 100 );
        }
        break;
      case 38:
        //strip.colorSpin( rowCenSegments, spinPatternUSflag, SIZE(spinPatternUSflag), pallet, 0, 1, false, 130, 100 );
        break;
      case 39:
        for (int i = 0; i < 2; i++) {
          breakEffectCheck();
          tempRandPallet[0] = 0; //background color for spin patterns (off)
          rowCenSegments.flipSegDirectionEvery(1, true);
          //strip.colorSpin( rowCenSegments, spinPatternHeart, SIZE(spinPatternHeart), tempRandPallet, 0, 2, true, 100, 110 );
        }
        break;
      case 40:
        //rainbow() only does one full cycle, we'll do 3 to extend its duration
        for (int i = 0; i < 3; i++) {
          breakEffectCheck();
          //strip.rainbow(35);
        }
        break;
      default:
        //if we don't find an effect for the current effectIndex, we'll move to the next effect
        //this is for when an effect is set to always be skipped
        //incrementEffectIndex();
        break;
    }
    //if effectRota is true we'll advance to the effect index
    if (effectRota) {
      incrementEffectIndex();
    }
    strip.stripOff(); //clear the strip for the next effect
  }
  
}

//a quick shortening of the random color function, just to reduce the pattern function calls more readable
uint32_t RC() {
  return strip.randColor();
}
