AlbertGBarber/Pixel-Mask/(commit log)

2020-07-08 Inital Commit
    [Battery Strap Mount V2.stl, Box.stl, Button Cap.stl, Lid.stl, PCB_pixel_layout.dxf, Pixel Layout.xlsx, Strap Cable Guide.stl, Wemos Box Strap Mount.stl]
2020-07-08 Added Printed Parts
    [Box.stl, Button Cap.stl, Lid.stl, button.stl]
2020-07-24 Updated V2 Box
    [Box.stl, Lid.stl]
2020-07-27 updated 3d print files
    [Box.stl, Button Cap.stl, Lid.stl]
2020-08-06 Added rear battery strap mount
    [Battery Rear Strap Mount pt 1.stl, Battery Rear Strap Mount pt 2.stl]
2020-08-26 Re oganized files
    [PCB_pixel_layout.dxf]
2020-09-30 Prevented multiple writes to EEPROM
    uncommented detach statements to ensure eeprom is only commited once for a series of button presses
    [Pixel_Mask_Code.ino, Pixel_Mask_Code_Limited_Patterns.ino]
2020-10-26 Fixed missing lid file
    [Lid.stl]
2020-11-09 Small Update To images
    [PCB_pixel_layout.dxf]
2020-11-09 updated Box V2
    Also adjusted PCB ver code
    [BOM_Pixel Mask_2020-10-21_10-26-01.csv, Box.stl, Button Cap.stl, Lid.stl, PCB Pixel Layout.xlsx, PCB_pixel_layout.dxf, PickAndPlace_Left Right Panel_2020-10-21_10-26-17.csv, PickAndPlace_Left Half PCB_2020-10-21_10-26-27.csv]
2020-11-16 fixed column segment directions
    [Pixel_Mask_Code_Limited_Patterns_PCB.ino, Pixel_Mask_Code_PCB.ino, segmentDefsPCB.h]
2020-12-03 updated button cap stl
    [Button Cap.stl]
2020-12-05 updated box stl files
    [Box.stl]
