AlbertGBarber/Pixel-Mask/Images/IMG_20200513_101334.jpg

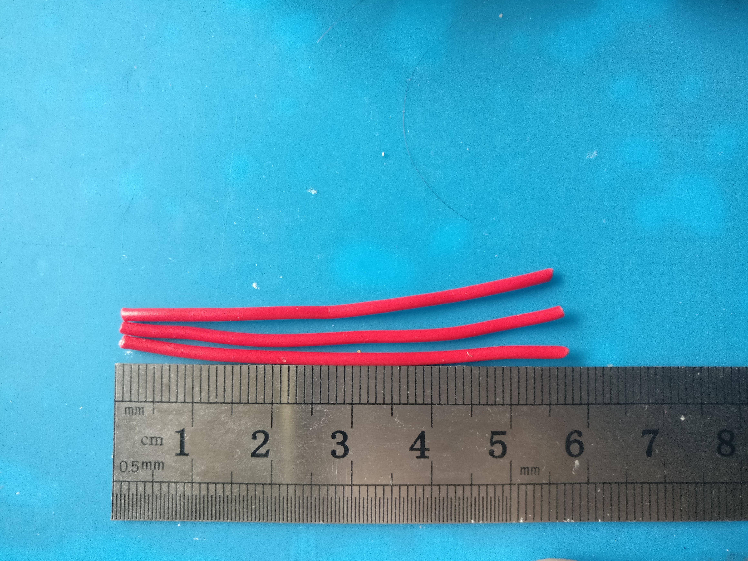
Images/IMG_20200513_101334.jpg
